leazer/MPS_MotorDriver/doc/msh_usart_dma_design_2026-06-24.md

# MSH 串口（USART1）DMA 化改造方案

日期：2026-06-24
作者：AI 协同（GLM-5.2 + 用户）
状态：✅ **已通过台架验证**（2026-06-24，用户确认整行粘贴不丢字符）

---

## 1. 背景

工程 MSH/finsh 控制台挂在 USART1（PB6 TX / PB7 RX，115200 8N1）。改造前的实现位于 `project/src/board.c:88-123`：

- `rt_hw_console_output`：**逐字节阻塞轮询** `USART_TDBE_FLAG` + `USART_TDC_FLAG`，每个字节都死等到完全发完才发下一个
- `rt_hw_console_getchar`：**直接读 `USART1->dt`**，硬件只有 1 字节 RDR，**无中断、无 FIFO、无环形缓冲**

### 1.1 现象

CLAUDE.md:133（Stage 2 调试结论）已记录：

> **finsh getchar 轮询限制**: `rt_hw_console_getchar()` (board.c) 是轮询读 USART, 无 RX 中断/FIFO. **一次性发送整行会 overrun 丢字符**. 自动化测试必须逐字符发送+等待回显 (tests/com9_test.py). Stage 8+ 若需高频调试可改 RX 中断驱动.

### 1.2 根因

USART1 硬件只有 1 字节接收寄存器（RDR）。115200 bps 下一个字节占 87 µs。当 finsh 在处理上一个字符、或 ISR（FOC TMR1_OVF 16 kHz / CAN_RX / EXINT2）抢占时，下一字节在 RDR 已被 USART 接收后若未及时被 CPU 读走，再到达的字节会触发 **ROERR overrun**，将前一字节冲掉。

FOC ISR 实测耗时 ~10-15 µs（电流读取 + Park/iPark + SVPWM + 标定 tick），加 SPI2 编码器读取 ~6 µs，单次 ISR 占 ~20 µs；115200 一字节 87 µs 余量本应足够，但 finsh 主循环 `finsh_thread_entry` (`shell.c:485`) 每读一个字符要做 echo + 行编辑 + 控制键状态机，处理一个字符耗时可超过 87 µs，外加 RT-Thread 调度延迟，**整行粘贴必然丢字符**。

## 2. 目标

| 维度 | 目标 |
|---|---|
| RX | 改 DMA 循环模式 + 软件环形 buffer（128 B），CPU 不再参与字符接收 |
| TX | 改 DMA 单次模式，一次推完整段字符串，仅在 DMA 完成时检查标志 |
| 接口 | `rt_hw_console_output` / `rt_hw_console_getchar` 签名不变，对 finsh / rt_kprintf 透明 |
| 系统耦合 | **不启用** `RT_USING_DEVICE`、不引入 serial 框架、不改 RT-Thread 源码、不新增中断 |
| RAM 预算 | ≤ 1 KB（RX ring 128 B + TX stage 256 B + 控制变量 ~16 B） |

## 3. 平台事实（改造前调研）

| 项目 | 值 |
|---|---|
| MCU | Artery AT32M412KBU7-4（**非 STM32**，AT32 标准外设库） |
| RT-Thread | Nano 4.1.x |
| 串口框架 | **无**（`RT_USING_DEVICE` 注释，纯 `rt_hw_console_*` weak hook） |
| 当前 DMA 使用者 | **0**（AT32 DMA 库 `at32m412_416_dma.c` 已编进固件但无人调用） |
| DMA 控制器 | DMA1（7 个通道 CH1-CH7） + DMAMUX（任意通道映射任意外设） |
| 参考实现 | 同根目录官方 `AT32M412_LV_MC_Library_Porject_V2.1.5/mclib/src/mc_comm_uart.c` 有完整 USART DMA TX/RX 示例 |

### 3.1 关键 AT32 库 API

```c
/* libraries/drivers/inc/at32m412_416_usart.h */
void usart_dma_transmitter_enable(usart_type* usart_x, confirm_state new_state);
void usart_dma_receiver_enable   (usart_type* usart_x, confirm_state new_state);

/* libraries/drivers/inc/at32m412_416_dma.h */
DMAMUX_DMAREQ_ID_USART1_TX = 0x19
DMAMUX_DMAREQ_ID_USART1_RX = 0x18
void dma_init(dma_channel_type *ch, dma_init_type *cfg);
void dma_flexible_config(dma_type *dma, dmamux_channel_type *mux_ch, dmamux_requst_id_sel_type req);
void dmamux_enable(dma_type *dma, confirm_state state);
void dma_channel_enable(dma_channel_type *ch, confirm_state state);
void dma_data_number_set(dma_channel_type *ch, uint32_t n);
uint16_t dma_data_number_get(dma_channel_type *ch);
flag_status dma_flag_get(uint32_t flag);
void dma_flag_clear(uint32_t flag);
```

## 4. 设计

### 4.1 DMA 通道分配（避免未来冲突）

| 通道 | 用途 | DMAMUX 请求 ID | 备注 |
|---|---|---|---|
| DMA1_CHANNEL1 | （预留 ADC） | — | 沿 STM32 习惯保留 |
| **DMA1_CHANNEL2** | **USART1_TX** | `DMAMUX_DMAREQ_ID_USART1_TX` (0x19) | 本次新增 |
| **DMA1_CHANNEL3** | **USART1_RX** | `DMAMUX_DMAREQ_ID_USART1_RX` (0x18) | 本次新增 |
| CH4 ~ CH7 | 预留 SPI2 MA600A / CAN / 其他 | — | — |

通道分配与官方 `AT32M412_LV_MC_Library_Porject_V2.1.5/user/inc/mc_hwio_m412_lv_v1_0.h:329-336` 一致，便于以后参考。

### 4.2 RX 工作原理（DMA 循环 → 软件环形 buffer）

```
                              ┌───────────────────────────┐
USART1 RDR                    │ s_rx_ring[128] (静态)     │
    │     RX_DMA 请求          │  ┌────────────────────┐  │
    └────────────────────────► │  │ 0  1  2 .. 127     │  │
                              │  └─▲──────────────────┘  │
                              │    │ DMA 写指针          │
                              │  (硬件: 128-CNDTR)        │
                              │                          │
                              │  s_rx_read_idx (软件读)  │
                              └───────────────────────────┘
```

- DMA1_CH3 配置 `loop_mode_enable = TRUE`，`buffer_size = 128`，方向 P2M
- 硬件在 CNDTR 到 0 时立即 reload 到 128 并继续搬运（环形）
- 软件 `write_idx = 128 - dma_data_number_get(CH3)` 始终落在 `[0, 128)`
- `getchar` 比较 `write_idx` 与 `s_rx_read_idx`：相等→无数据返回 -1；不等→取 `s_rx_ring[s_rx_read_idx]` 并 `(s_rx_read_idx+1) % 128`

**容量分析**：128 字节 @ 115200 = **11.1 ms 容忍窗口**。即使 finsh 整段卡 10 ms 不读，所有字符都能保留；远超原本 87 µs 的 1 字节窗口（提升 128×）。

**Overrun 策略**：如果 finsh 卡顿超 11 ms 导致 DMA 写指针追上软件读指针（即一整圈），最老的字符会被无声覆盖。这是设计上接受的失效——比当前 1 字节窗口好 128 倍，且实际 finsh 处理一行 < 1 ms，几乎不可能触发。

### 4.3 TX 工作原理（DMA 单次 + 等 FDT + 等 TDC）

```
rt_kprintf("msh />")
  └─ rt_hw_console_output("msh />")
      └─ board_usart1_tx_dma_send_str("msh />")
          ├─ 做 \n → \r\n 翻译，填 s_tx_stage[]
          └─ board_usart1_tx_dma_send(s_tx_stage, out_len)
              ├─ dma_channel_enable(CH2, FALSE)
              ├─ DMA1_CHANNEL2->maddr = stage 地址
              ├─ dma_data_number_set(CH2, out_len)
              ├─ dma_flag_clear(DMA1_GL2_FLAG)        ← 一次清全局 flag
              ├─ dma_channel_enable(CH2, TRUE)
              ├─ while(!dma_flag_get(DMA1_FDT2_FLAG)) ← 等 DMA 完成
              ├─ while(!usart_flag_get(USART1,TDC))   ← 等最后一字节移出
              └─ dma_channel_enable(CH2, FALSE)
```

- DMA1_CH2 配置 `loop_mode_enable = FALSE`，每次发送前设 maddr + buffer_size
- 调用方等 DMA FDT 完成；再等 USART TDC 确保最后一字节移出移位寄存器，避免下次 send 重置 maddr 时截断
- TX 仍是阻塞调用（保持与原 hook 一致的同步语义），但 **DMA 在传输期间不占 CPU**，FOC ISR 抢占时 DMA 仍继续推数据，丢字符窗口完全消失

**性能**：原实现每字节 = 2 次轮询 + 1 次写寄存器，每字节最坏 ~87 µs CPU 占用；新实现 N 字节一次 setup（~10 个寄存器写）+ N×87 µs 等 FDT（CPU 空转可被 ISR 抢占）。CPU 占用降低 ~10×。

### 4.4 不引入 IDLE 中断 / serial 框架的理由

- finsh `finsh_thread_entry` (`shell.c:487`) 主循环本就是 polling 模型：`while(1){ ch = finsh_getchar(); if(ch<0) continue; ... }`
- IDLE 中断的价值是"finsh 真正阻塞等数据时释放 CPU"，但 Nano 版 `finsh_getchar` 在 `RT_USING_DEVICE` 未开时就是 polling 返回 -1 + continue（`shell.c:148-189` 的 `#else` 分支），加 IDLE 无收益
- 启用 `RT_USING_DEVICE` 会拉入 serial 设备框架（v1 ~3 KB FLASH + 200 B RAM），不划算

## 5. 文件改动清单

| 操作 | 路径 | 行数变化 |
|---|---|---|
| 新增 | `platform/at32m412/board_usart1_dma.h` | +43 |
| 新增 | `platform/at32m412/board_usart1_dma.c` | +150 |
| 修改 | `platform/at32m412/board_init_at32m412.c` | +6 / -0 |
| 修改 | `project/src/board.c` | +17 / -32 |
| 修改 | `cmake/at32_workbench/CMakeLists.txt` | +1 |
| 修改 | `project/MDK_V5/MPS_MotorDriver.uvprojx` | +1 |
| 修改 | `CLAUDE.md` | 记录改造节点 |

### 5.1 改动要点

**`board_usart1_dma.h`** 暴露 4 个接口：
```c
void board_usart1_dma_init(void);
void board_usart1_tx_dma_send(const uint8_t *data, uint16_t len);
void board_usart1_tx_dma_send_str(const char *str);   /* 含 \n→\r\n 翻译 */
int  board_usart1_rx_dma_getchar(void);                /* 无数据返回 -1 */
```

**`board_usart1_dma.c`** 静态数据：
```c
static volatile uint8_t  s_rx_ring[128];   /* DMA 循环写入 */
static volatile uint16_t s_rx_read_idx;    /* 软件读指针 */
static uint8_t           s_tx_stage[256];  /* TX 准备缓冲 (\n→\r\n 最坏翻倍) */
```

**`board_init_at32m412.c::board_usart1_init()`** 末尾追加：
```c
usart_enable(USART1, TRUE);
board_usart1_dma_init();   /* ← 新增 */
```

**`project/src/board.c`** 两个 hook 简化为：
```c
void rt_hw_console_output(const char *str)   { board_usart1_tx_dma_send_str(str); }
char rt_hw_console_getchar(void)             { return (char)board_usart1_rx_dma_getchar(); }
```

## 6. 不改动的部分

- `rtconfig.h` / `finsh_config.h` 完全不动
- RT-Thread Nano 源码不动
- finsh 不动
- NVIC 不动（本方案 0 中断；DMA 完成靠轮询标志，避开 FOC/CAN 高优先级 ISR 争用）
- 其他外设（PWM/ADC/SPI2/CAN）完全无关

## 7. 风险与缓解

| 风险 | 缓解 |
|---|---|
| DMAMUX 配置顺序错位 → 通道工作异常 | 严格对齐官方 `mc_comm_uart.c` 顺序：`dma_init` → `dmamux_enable` → `dma_flexible_config` → `dma_channel_enable` |
| 循环 DMA 的 CNDTR 边界（满量 vs 0） | DMA reload 瞬间 CNDTR 会从 0 跳回 128，`write_idx = 128 - CNDTR` 配合模运算读指针正确（与 mc_comm_uart.c:141 同算法） |
| TX `\n→\r\n` 翻译后溢出 stage | `RT_CONSOLEBUF_SIZE = 128`，stage = 256 恰好容纳最坏翻倍；越界截断不阻塞 |
| RX 卡 > 11 ms 导致环形覆盖 | 接受失效（仅丢老字符），实际 finsh 处理一行 < 1 ms |
| 改造期间 console 完全失效 | 改动局限 board 层，可一次构建一次烧录验证；保留 git diff 可快速回退 |

## 8. 资源占用预估

- **FLASH**: +~600 B（新 .c 约 150 行 + DMA 库已编进固件无增量）
- **RAM**: +~410 B（s_rx_ring 128 + s_tx_stage 256 + 控制变量 ~16 + 函数栈 ~10）
- 当前 RAM 9520/16384 (58.11%) → 预计 ~9930 B (60.6%)，留 6 KB 空闲

## 9. 验证计划（待台架）

1. **构建**：WSL `cmake --build build/Debug` 和 Keil rebuild 均需 0 Error
2. **启动横幅**：上电后串口能看到 `\ | /` RT-Thread banner + `msh />` 提示符，且 `\r\n` 正确（终端不出现阶梯）
3. **回显**：逐字符敲 `help` 回车，回显与原行为一致
4. **关键回归**：终端一次性粘贴一行命令 `mc_open 1000 60 ramp`（>20 字符）→ **不再丢字符**，原本必丢
5. **批量回归**：用 Python 脚本一次性 `ser.write(b"mc_state\r\nfault\r\nencoder\r\n")` 不丢字符；与改造前 `tests/com9_test.py` 必须逐字符发的限制对比
6. **高负载场景**：在 `mc_open` / `mc_cur` ISR 持续 16 kHz 运行下做步骤 4，验证 DMA 不被 ISR 抢占影响
7. **长字符串 TX**：`mc_cal_dump`（256 行）输出不卡顿、不截断
8. **RAM/FLASH 占用**：与预估对比

## 10. 后续优化（不在本次范围）

- 若以后 SPI2 / ADC 都接 DMA 后调试发现 DMA1 总线竞争，可考虑：
  - 提高 USART1_TX/RX 通道 `priority` 字段（当前 LOW）
  - 或把 USART RX 改成 IDLE 中断 + 短帧 DMA，减少 DMA 占用率
- 若启用 `RT_USING_DEVICE` 把 USART 注册为 serial v2 device，可：
  - finsh 真正阻塞睡眠等 RX 信号量（IDLE 中断释放信号量），CPU 利用率更低
  - 支持 `rt_console_set_device` 切到 SWO/CAN 等

---

## 附录 A：当前 vs 新实现对比

| 维度 | 改造前 | 改造后 |
|---|---|---|
| TX 实现 | 逐字节 `usart_data_transmit` + 死等 TDBE+TDC | 一段 DMA + 等 FDT+TDC |
| TX CPU 占用 | 100%（每字节死等 87 µs） | ~10%（仅 setup + 等 FDT，可被 ISR 抢占） |
| RX 实现 | 直读 `USART1->dt`（仅 1 字节硬件 FIFO） | DMA 循环写入 128 B 环形 buffer |
| RX 丢字符窗口 | 87 µs（1 字节） | 11.1 ms（128 字节） |
| 抗 ISR 抢占 | 差（FOC 抢占即丢） | 优（DMA 与 CPU 并行） |
| 中断使用 | 0 | 0（DMA 完成靠轮询） |
| RAM 增量 | 0 | ~410 B |
| FLASH 增量 | 0 | ~600 B |
| 接口兼容性 | — | 完全兼容（hook 签名不变） |

## 附录 B：参考代码引用

- AT32 USART DMA 示例：`AT32M412_LV_MC_Library_Porject_V2.1.5/mclib/src/mc_comm_uart.c:42-95`（TX/RX DMA 初始化）
- AT32 USART DMA 通道分配：`AT32M412_LV_MC_Library_Porject_V2.1.5/user/inc/mc_hwio_m412_lv_v1_0.h:329-336`
- finsh getchar 主循环：`middlewares/rt-thread/components/finsh/shell.c:148-189`
- 原 console hook：`project/src/board.c:88-123`（改造前版本）
