leazer/MPS_MotorDriver/docs/superpowers/specs/2026-07-27-serial-forum-posts-video-redesign.md

# V2 四篇连载、比赛提交帖与 PPT 主线视频改版设计

日期：2026-07-27

## 1. 改版目标

保留原长篇草稿
`doc/第四篇过程帖_V2硬件与三环CAN调试_论坛草稿.md` 作为资料归档，
不删除、不覆盖。正式论坛内容改为第四至第七篇四篇短连载，并同步改写
最终比赛作品提交帖和演示视频脚本。

四篇连载都采用“图片先讲清楚，文字负责串联”的形式：

- 每篇约 1500～2500 个中文字符；
- 每篇安排 5～8 个清晰的图片占位；
- 延续前三篇的第一人称工程记录口吻；
- 已验证、正在调试和待补结果严格分开；
- 不重复堆叠安全上电流程和完整测试报告。

建议文件名：

1. `doc/第四篇过程帖_V2同轴磁编改版与波形_论坛草稿.md`
2. `doc/第五篇过程帖_三环LKS_Scope波形调试_论坛草稿.md`
3. `doc/第六篇过程帖_CAN协议与单节点联调_论坛草稿.md`
4. `doc/第七篇过程帖_五连杆轮腿Demo设计_论坛草稿.md`

## 2. 第四篇：V2 同轴磁编改版与波形

### 2.1 内容重点

1. 承接 V1：旁轴磁编能工作，但磁铁、传感器、转轴之间的相对位置让装配和
   标定更敏感，因此 V2 改为同轴布局。
2. 展示 V2 PCB Layout：MA600A 与电机轴线关系、磁铁位置、机械固定方式，
   以及相关布线变化。
3. 展示 PCB 和电机模组实物，强调结构更直接、装配关系更明确。
4. 说明采集链路：TMR7 以 4 kHz 独立采样，16 kHz FOC 中断读取已发布快照，
   避免在控制中断内直接阻塞 SPI。
5. 以手拖电机的 raw/corrected 角度波形为主要证据，观察连续性、周期回绕和
   毛刺情况。
6. V1 只有一张未标定波形，因此只作为背景参考，不写成严格同工况 A/B 测试。
7. 结论重点放在 V2：同轴安装后原始角度已经具备较好的可用性，标定从
   “补偿安装偏差”更接近“小误差修整”，标定难度明显下降。

### 2.2 表述边界

- 可以引用两套 V2 板自动标定均覆盖 256 bins、已有内部指标 115 mdeg 和
  60 mdeg、采集期间 spike 为 0。
- 115/60 mdeg 是内部 correction table 质量指标，不宣称为外部基准下的
  绝对精度。
- “接近直接使用”需由 V2 手拖 raw 波形的连续性支撑，不扩写成无需校准即可
  达到某一绝对精度。
- 本篇不介绍按安全顺序检查电源、PWM、驱动使能等上电流程。

### 2.3 图片规划

```text
[P4-01] V1 旁轴磁编结构或旧版 PCB 局部
[P4-02] V2 同轴磁编 Layout 总览
[P4-03] MA600A、磁铁与电机轴线局部放大
[P4-04] V2 PCB 与电机模组实物
[P4-05] 4 kHz 采集 / 16 kHz 控制数据链路图
[P4-06] V1 唯一一张未标定拖动波形（背景参考）
[P4-07] V2 手拖 raw 角度主波形
[P4-08] V2 corrected 波形或标定结果摘要
```

## 3. 第五篇：三环逻辑与 LKS Scope 调试

### 3.1 内容重点

1. 用一张图说明三环级联：
   `位置环 → 速度目标 → 速度环 → Iq 目标 → 电流环 → SVPWM`，
   编码器反馈位置/速度，电流采样反馈 Id/Iq。
2. 简介目前正在搭建的 LKS Scope 在线调参方案：
   `g_motor_tuning` 集中保存 RAM 在线参数，
   `g_motor_loop_debug` 提供运行快照。
3. 原有 11 条 Chart 曲线保持不变，数值表扩展到约 137 项；用户在
   LKS Scope 内按电流、速度、位置三个阶段自行选曲线。
4. 以图为主，分别放电流环阶跃、速度跟随、位置跟随三类代表波形。
5. 每张图只用一小段文字说明“目标、反馈、误差、输出/饱和状态怎么看”，
   不把正文写成完整 PID 教程。

### 3.2 表述边界

- LKS Scope 方案仍在构建和实机整理中，正文先给出真实架构和截图占位。
- 在线参数只存在 RAM，复位恢复默认值，不写成已经实现参数掉电保存。
- 不提前宣称最终三环波形已全部达到理想指标。

### 3.3 图片规划

```text
[P5-01] 位置—速度—电流三级级联逻辑框图
[P5-02] LKS Scope 在线参数与运行快照结构
[P5-03] LKS Scope 数值表/变量分组界面
[P5-04] Iq 电流环正向阶跃响应
[P5-05] Iq 电流环正反向或不同幅值阶跃
[P5-06] 速度目标与实际速度跟随
[P5-07] 位置目标与实际位置跟随
```

## 4. 第六篇：CAN 协议与单节点联调

### 4.1 内容重点

1. 用协议框架图说明 X-Track 与两个 MotorDriver 节点之间的关系。
2. 简述 Classic CAN、11-bit、DLC=8、1 Mbps，以及四类 ID：
   广播 `0x080`、轨迹 `0x100+node`、反馈 `0x180+node`、
   健康 `0x280+node`。
3. 用一张时序图说明“节点预装轨迹点 + 广播 SYNC”，以及
   DISCOVER、ARM、RUNNING/HOLD、STOP/FAULT。
4. 选取 `can_protocol.h/.c` 和 `can_motion_service.c` 的短代码片段，
   展示协议定义、命令分发和 1 kHz 服务。
5. 用历史日志讲一个真实调试问题：总线无 ACK 时进入 bus-off，持续错误中断
   一度让 COM9 看似卡死；改为 10 ms 状态轮询后，串口仍可响应，节点进入
   FAULT，EN 关闭。
6. 展示 X-Track 单节点 60 s 实测：最大 `sync_age=19 ms`，位置参考无冻结，
   protocol error / RX overflow / bus-off / TX error 均无增长。

### 4.2 已有素材与待补素材

现有材料足以生成论坛配图，不需要重新复现全部调试：

- `doc/调试记录.md` 第 1547～1644 行附近包含协议、超时、bus-off 与测试摘要；
- `docs/motor-control/test-reports/2026-07-22-xtrack-position-response.md`
  包含 60 s 实机结论与 CAN 错误统计；
- `docs/motor-control/evidence/` 保存 4 组原始 JSONL 和 Kp=5/7.5/10 汇总；
- `tests/stage8_can_bench.py`、`tests/stage8_canalyst_node1.py`、
  `tests/capture_xtrack_position_response.py` 保存台架与采集脚本；
- 协议和状态机源码均已保存。

目前没有现成 PNG/JPG。正式制作时把代码、终端日志和测试摘要排成三张统一风格
的清晰图片。若用户方便，再补一张 X-Track 实机控制画面或 CAN 分析仪收发界面，
但它不是成文前置条件。

### 4.3 表述边界

- 只写单节点 CAN 实机时序和安全验证已经通过。
- 10°位置响应没有达到既定 9.5°/350 ms 门槛，不能用 CAN 时序通过替代动态
  响应通过。
- Node 2 永久关节配置、双节点 applied sequence 一致性和五连杆联动仍按
  当前真实进度描述。

### 4.4 图片规划

```text
[P6-01] X-Track—CAN—双 MotorDriver 协议框架
[P6-02] 四类 CAN ID 与 8 字节载荷摘要
[P6-03] 预装轨迹点 + 广播 SYNC 时序图
[P6-04] can_protocol.h/.c 核心代码截图
[P6-05] can_motion_service 状态机/超时代码截图
[P6-06] 无 ACK → bus-off → 安全 FAULT 调试日志
[P6-07] X-Track 单节点 60 s 测试结果摘要
[P6-08] 可选：CAN 分析仪或 X-Track 实机界面
```

## 5. 第七篇：五连杆轮腿 Demo 设计

### 5.1 叙事开场

电机驱动模块完成后，需要一个既直观、又能体现双电机同步价值的展示载体。
论坛里已有坛友做力反馈旋钮、交互机器人等作品，最后选择用两个电机构成一个
五连杆轮腿 Demo：它本身是当前轮足机器人中常见的腿部模块，也能自然覆盖双
节点位置控制、机构运动学、3D 打印和装配联调。

### 5.2 数学原理

定义两个固定主动关节为 \(A\)、\(B\)，主动臂末端为 \(C\)、\(D\)：

\[
C=A+l_1[\cos\theta_1,\sin\theta_1],\qquad
D=B+l_2[\cos\theta_2,\sin\theta_2]
\]

末端点 \(P\) 是以 \(C\)、\(D\) 为圆心、以 \(l_3\)、\(l_4\) 为半径的两个圆
的交点。令：

\[
r=|D-C|,\quad
a=\frac{l_3^2-l_4^2+r^2}{2r},\quad
h=\sqrt{l_3^2-a^2}
\]

取 \(e=(D-C)/r\)，法向量 \(n=(-e_y,e_x)\)，则：

\[
P=C+ae\pm hn
\]

正负号对应两种装配支路，软件中固定选择与实物一致的一支。正文只解释几何意义，
不代入未确认的连杆尺寸，也不展开成冗长推导。

### 5.3 机械与控制方案

1. 展示五连杆 CAD 总装、连杆、轴承/紧固件、电机安装和 3D 打印方案。
2. 简述装配时需要统一机械零位、方向和软限位。
3. 用改造后的 X-Track 作为 CAN 示教/控制器，产生两个关节目标。
4. X-Track 分别向 Node 1/2 预装轨迹点，再发广播 SYNC；两块 MotorDriver
   各自完成位置—速度—电流三级闭环。
5. 当前双电机硬件已经搭建完成，X-Track 实际控制和最终动作仍在 debug。

### 5.4 图片规划

```text
[P7-01] 论坛常见展示形式与五连杆选择思路
[P7-02] 五连杆机构自由度与关节命名图
[P7-03] 两圆求交的正运动学示意图
[P7-04] 五连杆 CAD 总装截图
[P7-05] 关键零件/尺寸或工程图截图
[P7-06] 3D 打印件与装配过程
[P7-07] X-Track—CAN—双电机—五连杆结构框图
[P7-08] 已完成的双电机硬件实物，最终动作待补
```

## 6. 最终比赛作品提交帖

作品帖作为完整总览，不复制四篇过程帖的全部细节，主要结构为：

1. 作品简介与完成效果；
2. 电机模组总体设计框图；
3. MP4583、MP6540H、MA600A 与 AT32M412 的硬件分工；
4. 核心代码模块：
   `encoder_service`、`current_reconstruction`、`foc_core`、
   `current/speed/position_loop`、`motor_tuning`、`can_protocol`、
   `can_motion_service`、`joint_config`、`fault_manager`；
5. 五连杆 Demo 的选择理由和结构设计原理；
6. CAD/机械图、打印、装配和成品展示；
7. 调试结果的紧凑汇总与四篇过程帖链接；
8. 最终动作图片/GIF、视频链接、源码链接和总结。

最终效果未完成前继续保留唯一编号占位，不把“硬件已搭建”写成“完整动作已通过”。

## 7. 3 分 10 秒～3 分 30 秒 PPT 主线视频

### 7.1 表现形式

- 16:9、1080p/30 fps；
- AI 自动生成视觉风格统一的演示型 PPT 作为主线；
- 开头插入约 10～12 秒露脸自我介绍；
- 中间插入编码器、三环、CAN 的少量实测截图；
- 结尾以 MPS 双电机五连杆实际动作作为高潮；
- 旁白使用第一人称口语，不照念论坛正文。

### 7.2 建议时间轴

| 时间 | PPT/实拍内容 |
| --- | --- |
| 0:00–0:12 | 露脸：一句自我介绍 + 作品是什么 |
| 0:12–0:30 | 项目缘起：想做一块真正能带电机的紧凑驱动模块 |
| 0:30–0:52 | 模组总体框图与 MPS 器件 |
| 0:52–1:12 | V1 到 V2，同轴磁编改版 |
| 1:12–1:32 | 手拖波形与更容易标定的结果 |
| 1:32–2:00 | 三环逻辑 + 三张 LKS Scope 代表波形 |
| 2:00–2:20 | CAN 协议、SYNC 与一张联调日志 |
| 2:20–2:45 | 为什么选择五连杆、运动学与机械设计 |
| 2:45–3:18 | CAD/打印/装配快速过渡 + 最终动作实拍 |
| 3:18–3:28 | 随性收尾与项目链接 |

### 7.3 低成本制作方式

1. 先从本设计生成 10 页左右的 PPT 文案和统一视觉提示词；
2. 用 AI 演示工具生成基础页面，只手动替换 Layout、波形、CAD 和实物图；
3. PPT 导出视频或逐页录屏，转场只保留淡化、平移和局部放大；
4. 开场露脸一次拍完，技术画面使用后期旁白；
5. 五连杆最终动作固定机位连续拍 30～60 秒，再从中选 20～30 秒；
6. 没有最终动作时先完成除最后一页外的全部剪辑，联调完成后只替换末段。

## 8. 验收标准

1. 原 V2 长篇草稿原样保留；
2. 新建第四至第七篇四个独立 Markdown 草稿；
3. 第四篇不包含安全上电检查流程，不做伪严格 V1/V2 横评；
4. 第五篇以三环框图和 LKS Scope 波形为主；
5. 第六篇使用真实协议、代码、历史日志和单节点 60 s 证据；
6. 第七篇包含简洁可靠的五连杆几何原理和 X-Track 控制框图；
7. 最终作品帖改为完整模组与五连杆总览；
8. 视频脚本为 3:10～3:30 的 PPT 主线，旁白口语随性；
9. 双节点和最终动作没有完成前均保留明确占位。
