leazer/MPS_MotorDriver/docs/superpowers/specs/2026-07-29-final-submission-mps-writing-review-design.md

# 最终比赛作品提交帖：MPS 实体书写结果改版设计

日期：2026-07-29

## 1. 目标

根据用户已经修改的作品简介和最新实机结果，生成一份独立审阅稿：

`doc/最终比赛作品提交帖_根据新版简介调整_审阅稿.md`

原文件
`doc/最终比赛作品提交帖_论坛草稿.md`
保持不变，供用户对照。

## 2. 已确认事实

- 两套 V2 电机驱动与五连杆机构已经完成搭建和双节点联调。
- X-Track 使用预先生成的 MPS 末端轨迹，不是手动示教轨迹。
- 五连杆末端夹笔，已经在纸面留下实际的连续 MPS 笔迹。
- 整段轨迹能够流畅跑完。
- 当前字形效果一般，重复稳定性一般，仍有优化空间。
- 示教功能没有实现，审阅稿中删除或弱化相关描述。
- 没有可引用的轨迹误差、重复成功率、书写时长等量化结果，不得虚构。

## 3. 改写策略

采用“结果驱动、保留工程过程”的方案：

1. 保留原稿 13 节总体框架和前半篇已验证的硬件、三环、CAN 内容。
2. 从五连杆设计开始，将叙事从“计划用来验证”改为“已经落地到实体书写”。
3. 增加完整运行链路：

```text
预生成 MPS 末端坐标
  -> 轨迹缩放与离散
  -> 五连杆逆运动学
  -> Node 1 / Node 2 关节角
  -> CAN 轨迹预装 + 广播 SYNC
  -> 两个节点本地位置/速度/电流闭环
  -> 五连杆末端夹笔书写
```

4. 正面展示已经完成 MPS 实体书写，同时明确字形与重复稳定性一般。
5. 不用“完美复现”“高精度书写”“稳定重复”等缺少证据的宣传措辞。

## 4. 分节调整

### 第 1～5 节

- 保留用户修改后的简介、作者名和 AI 项目动机。
- 只做必要的中文标点、语序和论坛阅读节奏调整。
- 系统框图中的“旋钮 / 示教轨迹”改为“预设 MPS 轨迹 / 预设动作”。
- 保留 MP4583、MP6540H、MA600A、V2 同轴、三环与核心代码模块内容。

### 第 6 节：五连杆 Demo 设计

- 保留选择五连杆的理由和两圆求交正运动学。
- 补充实际控制使用逆运动学：从末端 MPS 坐标反求两个主动关节角。
- 将五连杆定位为双节点同步和末端实体书写的最终展示机构。

### 第 7～8 节：打印与装配

- 保留 CAD、打印、修孔、间隙和机械零位内容。
- 删除“Node 2 仍待配置”等过期状态。
- 改为两套节点已按机构零位、方向和软限位完成整机配置。

### 第 9 节：联调过程与当前结果

- 保留从单板、三环、单节点到双节点机构的递进路径。
- 增加预生成 MPS 轨迹到双关节 CAN 目标的完整数据流。
- 结果表更新为：
  - Node 2 已进入整机配置；
  - 双节点能够协同完成整段 MPS 书写；
  - 运动整体流畅；
  - 字形质量和重复稳定性一般。
- 单节点 10°/350 ms 历史门槛仍作为早期空载调试边界，不用它否定最终低速书写结果。

### 第 10 节：最终效果展示

- 删除“联调完成后再补”的过期文字。
- 直接写明末端夹笔在纸面留下连续 MPS 实体笔迹。
- 图片规划：

```text
[FINAL-05] 五连杆夹笔运行过程或连续动作截图
[FINAL-06] 纸面最终 MPS 笔迹近照
[FINAL-07] 最终参赛视频链接
```

- 结果表述为：

```text
完成度：整段 MPS 轨迹能够连续跑完
运动观感：整体流畅
当前不足：字形效果一般，重复稳定性一般
```

### 第 11 节：源码与使用说明

- 保留现有固件模块和构建说明。
- 增加轨迹生成、轨迹离散、五连杆逆运动学和 X-Track CAN 下发的职责说明。
- 如果源码中具体文件名尚未确认，只写功能模块，不虚构路径。

### 第 12 节：AI 协作

- 保留“以本项目测试 AI 在硬件开发中的作用”的主线。
- 将“剩下的能交给 AI 就让它去搞”整理成更自然的论坛表达。
- 强调 AI 参与资料梳理、代码、测试、排障记录和内容整理，最终结果仍由实物验证。

### 第 13 节：总结

- 从“仍在等待双节点联动”改为已经完成：

```text
V1/V2 驱动设计
  -> 同轴磁编
  -> 三环闭环
  -> 双节点 CAN
  -> 五连杆机构
  -> 纸面 MPS 实体书写
```

- 诚实保留字形、机械间隙、笔尖摩擦、零位一致性和重复稳定性等优化方向。

## 5. 文风

- 第一人称、工程论坛口吻，保留“两个吃灰电机”“这碟醋”“饺子包大了”等作者表达。
- 结果说清楚，但不改成产品宣传稿。
- 将“整体跑通”和“效果仍一般”同时写出来，避免只报喜或刻意贬低。
- 图片占位写明拍什么、证明什么，方便用户后续替换。

## 6. 验收标准

1. 新建独立审阅稿，不修改用户当前原稿。
2. 全文不再出现 Node 2 待配置、双节点联调中、最终轨迹待验证等过期状态。
3. 明确写出预生成轨迹，不出现已实现示教功能的结论。
4. 明确写出纸面实际 MPS 笔迹、整段流畅跑完。
5. 同时写出字形质量和重复稳定性一般。
6. 不虚构量化误差、运行时长、重复次数和成功率。
7. 后半篇与用户新版作品简介的完成状态一致。
