leazer/MPS_MotorDriver/doc/调试记录.md

# 调试记录

本文件记录样板调试、异常定位、参数调整和实测结果。所有测试记录尽量包含输入条件、连接方式、测试仪器、原始现象、判断过程和结论。

## 调试安全原则

1. 首次上电使用限流电源，电流限值从较低值开始。
2. 电机接入前先验证电源、MCU、传感器和驱动禁用状态。
3. MP6540H 使能前确认 PWM 默认状态、故障引脚状态和电源电流。
4. MA600A 安装和读取异常时，不急于闭环驱动电机。
5. 任何冒烟、异味、异常温升、异常电流，立即断电并记录现象。

## 调试记录模板

```text
日期：
记录编号：
调试目标：
硬件版本：
固件版本/提交号：
供电条件：
电机/负载：
测试设备：
连接方式：
操作步骤：
观测结果：
异常现象：
初步判断：
AI 辅助分析：
人工验证：
处理措施：
结论：
照片/波形/日志文件：
下一步：
```

## 2026-06-03 计划调试项

| 编号 | 调试项 | 状态 | 关键记录 |
| --- | --- | --- | --- |
| D001 | 样板外观和焊接方向检查 | 未开始 | 正反面照片、芯片方向、焊点、连接器 |
| D002 | 电源输入对地阻抗检查 | 未开始 | VIN-GND、低压电源轨-GND 阻值 |
| D003 | 限流电源首次空载上电 | 未开始 | 输入电压、电流限值、静态电流、温升 |
| D004 | MP4583 输出电压检查 | 未开始 | 输出电压、纹波、负载条件 |
| D005 | MCU 下载和串口日志 | 未开始 | 下载结果、启动日志 |
| D006 | MA600A 通信读取 | 未开始 | 原始角度值、旋转连续性 |
| D007 | MP6540H 禁用状态检查 | 未开始 | 使能脚、PWM 默认状态、故障脚、电源电流 |

---

## 2026-06-22 调试串口 finsh 接通 (3 轮调试)

### 背景
Stage 1 硬件 Bring-up 完成后, 接入 RT-Thread finsh/msh 调试控制台, 以便后续 Stage 通过 msh 命令自主闭环验证. 串口硬件: USART1 PB6(TX)/PB7(RX) 115200 8N1, 经 USB-TTL 连接 PC. 用户使用可控电源, 整体安全性可放心调试.

### 第 1 轮: 串口完全无输出

**现象**: 烧录后串口工具收不到任何数据 (完全静默).

**排查过程**:
1. 检查 finsh 配置: `RT_USING_FINSH` (finsh_config.h) 和 `RT_USING_CONSOLE` (rtconfig.h) 两个宏都被注释 → finsh 组件和 console 后端不编译.
2. 检查 USART1 硬件: `wk_usart1_init` 已在 Stage 0 Task 7 清空, platform 层 `board_init_at32m412.c` 未补 USART1 初始化 → 串口硬件未配置.
3. 检查引脚复用: `board_motor_pins.h` 里 USART1 的 `IOMUX` 写成 `GPIO_MUX_0`, 但 BSP 生成器 (git 6bbe9bd) 实际用 `GPIO_MUX_7` → 引脚复用选错 AF, 即使配置了也不工作.
4. 检查 finsh 源码: `shell.c / msh.c / msh_parse.c / cmd.c` 未纳入 CMake `RT-Thread_Nano_Src` 和 Keil .uvprojx 编译列表 → 宏开了也链接失败 (undefined reference to finsh_system_init).

**修复**:
- `finsh_config.h`: 开启 `RT_USING_FINSH`
- `rtconfig.h`: 开启 `RT_USING_CONSOLE`
- `board_motor_pins.h`: USART1 IOMUX `MUX_0` → `MUX_7`
- `board_init_at32m412.c`: 新增 `board_usart1_init()` (PB6/PB7 MUX_7 + 115200 8N1)
- `board.c`: `uart_init()` 改调 `board_usart1_init()`
- CMake + Keil: 纳入 finsh 4 个 .c 源文件
- 新建 `motor_shell.c`: 8 个 msh 命令 (pwm_info/pwm_duty/pwm_en/led/mc_state/fault/fault_clear/encoder)

**结果**: 编译链接通过, 但烧录后仍无输出.

### 第 2 轮: 串口初始化时序错误

**现象**: 第 1 轮修复后烧录, 串口仍完全静默.

**排查过程**:
梳理 RT-Thread 启动链路, 发现初始化顺序问题:
```
rt_hw_board_init()
  ├─ wk_system_clock_config()          ← 时钟 OK (180MHz)
  ├─ wk_periph_clock_config()          ← 已清空! 空操作!
  ├─ wk_nvic_config()                  ← 已清空! 空操作!
  ├─ rt_components_board_init()
  │    └─ uart_init() → board_usart1_init()  ← 此时 GPIOB/USART1 时钟未开!
  └─ SysTick_Config()

main()
  └─ motor_app_init()
       └─ board_clock_init()           ← 这里才开 GPIOB/USART1 时钟, 太晚了!
```

**根因**: `board_usart1_init()` 在 `rt_components_board_init` 阶段执行时, `CRM_USART1_PERIPH_CLOCK` 和 `CRM_GPIOB_PERIPH_CLOCK` 都没开 (它们在 `board_clock_init` 里才开, 而那要等到 main 线程的 `motor_app_init`). 往没开时钟的 USART1 寄存器写配置等于没写.

用户也指出 main.c 重复调用了 `clock_at32m412_init()` (与 `rt_hw_board_init` 里的 `wk_system_clock_config` 重复).

**修复**:
- `board.c` `rt_hw_board_init`: 把 `wk_periph_clock_config()`/`wk_nvic_config()` 替换为 `board_clock_init()`/`board_gpio_init()`/`board_nvic_init()` (在 `rt_components_board_init` 之前执行)
- `main.c`: 去掉重复的 `clock_at32m412_init()`
- `motor_app.c`: 去掉重复的 `board_clock_init/board_gpio_init/board_nvic_init` (已在 rt_hw_board_init 执行)

**结果**: 烧录后串口能打印 RT-Thread 版本横幅, 但没有 `msh />` 提示符, 无法输入.

### 第 3 轮: finsh 线程得不到调度

**现象**: 串口能打印版本横幅, 但没有 `msh />` 提示符, 无法输入命令.

**排查过程**:
版本横幅由 `rt_show_version()` 在 `rt_system_scheduler_start()` 之前打印 (不需要调度器). `msh />` 由 finsh 线程打印, 需要调度器启动后 finsh 线程被调度.

检查线程优先级:
- main 线程: 优先级 10 (RT_MAIN_THREAD_PRIORITY)
- finsh 线程: 优先级 21 (FINSH_THREAD_PRIORITY)
- 数值越大优先级越低

检查 `motor_app_run()`:
```c
void motor_app_run(void)
{
    while (1) {
        /* 空循环! 没有任何 rt_thread_mdelay / rt_thread_yield */
    }
}
```

**根因**: main 线程在 `motor_app_run` 的空 while(1) 里死循环, 不让出 CPU. 由于 main 线程优先级 (10) 高于 finsh 线程 (21), finsh 线程永远得不到调度, `msh />` 永远不出现.

**修复**: `motor_app_run()` while 循环加 `rt_thread_mdelay(10)`, 让 main 线程每 10ms 主动挂起, 给 finsh 线程调度机会.

**结果**: 烧录后出现 `msh />` 提示符, 所有 msh 命令可正常输入执行. `pwm_info` / `pwm_duty` / `pwm_en` / `mc_state` / `fault` / `led` 全部工作正常.

### 额外: LED 极性

**现象**: `led 1` 灭, `led 0` 亮, 与预期相反.

**根因**: 硬件 LED 负极接 IO, 低电平点亮. 程序里 `led 1` 执行 `gpio_bits_set` (高电平), 实际是灭.

**修复**: `motor_shell.c` led 命令反相 — `led 1` 执行 `gpio_bits_reset` (低电平=亮), `led 0` 执行 `gpio_bits_set` (高电平=灭). `board_gpio_init` 初始电平改为 set (灭). `board_motor_pins.h` 标注 LED 极性.

### 台架验证结果 (2026-06-22)

| 验证项 | 命令 | 结果 |
| --- | --- | --- |
| 串口版本横幅 | (上电自动) | ✅ 115200 8N1 正常打印 |
| msh 提示符 | (上电自动) | ✅ `msh />` 出现 |
| LED 控制 | `led 1` / `led 0` | ✅ 1=亮 0=灭 (修复极性后) |
| PWM 配置查看 | `pwm_info` | ✅ ARR=5624, 16kHz, CCR=2812(50%) |
| PWM 波形 | (示波器) | ✅ PA8/PA9/PA10 = 16kHz 中心对齐 50% |
| 状态机 | `mc_state` | ✅ state=0 mode=0 fault=0x40 (CAL_INVALID, 预期) |
| 故障查看 | `fault` | ✅ CAL_INVALID (标定未加载, 预期) |

### 踩坑总结 (后续避免)

1. **RT-Thread 初始化时序**: 板级硬件初始化 (时钟/GPIO) 必须在 `rt_components_board_init` 之前完成, 否则 INIT_BOARD_EXPORT 注册的设备初始化 (如 uart_init) 执行时硬件未就绪.
2. **main 线程 while 循环必须让出 CPU**: 否则所有低优先级线程 (finsh tshell 等) 饿死. 用 `rt_thread_mdelay` / `rt_thread_yield` / 等信号量.
3. **GPIO 复用编号查 BSP 生成器**: 手填 IOMUX 容易错, 以 Workbench 生成的 wk_*_init 里的 `gpio_pin_mux_config` 参数为准.
4. **ARMCC V5.06 默认 C90**: 不允许语句后声明变量 (GCC C11 允许). 跨编译器代码需用 C90 兼容写法 (变量声明在块开头).
5. **LED/继电器等外设极性**: 硬件接法决定 IO 电平语义 (低电平点亮 vs 高电平点亮), 代码需匹配, 头文件标注清楚.

---

## 2026-06-22 Stage 1 硬件 Bring-up (PWM 输出验证)

### 背景
Stage 0 基线重构完成后, Stage 1 实现最小集 TMR1 中心对齐 16kHz 3 路 PWM + 安全关断, 台架示波器验证波形.

### 关键决策: 系统时钟

spec §1.1 原标 96MHz, 但 `wk_system_clock_config` 实际配置 180MHz (PLL: 8MHz×90/(1×4)), 芯片 Flash 等待周期 5 支持 180MHz.

用户决定保持 180MHz (更强算力), 因此:
- `board_motor_pins.h`: `TMR1_CLOCK_HZ` = 180MHz, `TMR1_ARR` = 5624 (180e6/(2×16e3)-1)
- spec §1.1/§1.3/§1.4 时序常数同步更正为 180MHz

### 实现

- `board_init_at32m412.c`: 外设时钟 (GPIOA/B/TMR1/USART1/SCFG/PWC) + GPIO (nFAULT/LED/SPI2_CS/PWM_EN) + NVIC 优先级 (组4, TMR1_OVF=0/EXINT2=1/ADC=2/CAN=3/SysTick=14/PendSV=15, 仅设不使能)
- `motor_pwm_at32m412.c`: TMR1 中心对齐 TWO_WAY_3 + RCR=1 + ARR=5624 + 3路 PWM_MODE_A + CH4(ADC顶点触发预留) + brkdt禁用 + 50% 初始占空比
- `motor_app_init()`: 接入 board_init + motor_pwm_safe_init (MP6540H EN 保持低)

### 台架验证

示波器探 PA8/PA9/PA10, 确认 16kHz 中心对齐 50% 三相对齐波形. MP6540H_EN (PB10) 保持低 (禁用状态, 安全).

**结果**: ✅ PWM 波形正确, Stage 1 验收通过. (后通过 msh `pwm_info` 命令二次确认配置参数)

### RT-Thread 临界区发现

调研发现本工程 RT-Thread libcpu 的 `rt_hw_interrupt_disable` 用 PRIMASK (全局关中断), 非 BASEPRI. spec §3.5 原写的 `RT_KERNEL_BASEPRI` 不适用. Stage 1 不使能 TMR1_OVF 中断故无影响, FOC ISR 屏蔽风险留到 Stage 2/3 实测.

---

## 2026-06-22 Stage 0 基线重构

### 背景
工程原始为 AT32 Workbench 生成的扁平结构, 代码堆在 project/src/. 需重构为分层架构 (application/platform/communication) 以支持后续 FOC 开发.

### 完成
- 12 个 Task: 目录骨架 + 引脚/参数头文件 + 各层 stub + wk_*_init 清空 + main.c 精简 + CMake 纳入 + FLASH.ld 预留标定区 + 单元测试 + 文档
- 资源占用: FLASH 14712B / RAM 3552B (纯骨架, 无业务逻辑)
- 已有资产保留: motor_control 状态机, motor_pwm 安全接口, MA600A 驱动, 1 个状态机测试

### Keil 工程同步
Stage 0 完成后, Keil .uvprojx 与 CMake 源文件列表不同步 (Keil 只有 6 个旧源). 补全 17 个新源 + 4 个 include 路径 + IROM 127K. 写 build.bat / flash.bat / clean.bat 脚本调用 UV4.exe.

---

## 调试环境

- **硬件**: AT32M412KBU7-4 + MP6540H (三相半桥驱动) + MA600A (磁编码器) + JLink 调试器 + USB-TTL 串口 (PB6/PB7)
- **可控电源**: 用户使用可控电源, 整体安全性可放心调试
- **编译器**: Keil ARMCC V5.06 (-O1, C90) / WSL arm-none-eabi-gcc (-O0, C11)
- **构建**: `cd project\MDK_V5 && build.bat` (Keil) 或 `wsl cmake --build build/Debug` (GCC)
- **烧录**: `cd project\MDK_V5 && flash.bat` (JLink)
- **串口**: 115200 8N1, PB6(TX)/PB7(RX), finsh msh 提示符 `msh />`
- **示波器**: PA8/PA9/PA10 (PWM), PB10 (MP6540H EN)

---

## Stage 2: PWM 与开环控制 - 2026-06-22

### 记录编号
S2-001

### 阶段
Stage 2 (PWM 与开环控制)

### 目标
实现 FOC 核心变换 (Clarke/Park/IPark/SVPWM) + ISR 骨架 OPEN_LOOP 模式, 通过 msh 命令触发开环旋转, 验收三相电流正弦.

### 硬件版本
AT32M412KBU7-4 + MP6540H + MA600A

### 固件版本
Stage 2 完成 (WSL GCC + Keil ARMCC 双构建 0 error 0 warning)

### 供电条件
(待台架验收) 限流电源 12V, 限流 0.3A

### 电机/负载
2808 BLDC, 7 对极 (待实测确认)

### 仪器
JLink, USB-TTL 串口, 示波器 (PA8/PA9/PA10 PWM + 电流探头)

### 操作步骤
1. `cd project\MDK_V5 && flash.bat rebuild` 烧录
2. 串口连 PB6(TX)/PB7(RX) 115200, 见 msh 提示符
3. `mc_state` 确认 state=DISABLED, fault=0
4. `mc_open 1.0 60` (1V d 轴, 60rpm 电角度)
5. 示波器看 PA8/PA9/PA10 三相 PWM + 电流探头看相电流
6. `mc_debug` 观察 theta_e 递增, v_alpha/v_beta 正弦, CCR 限幅内
7. `mc_stop` 停止

### 观察结果
(待台架验收填写)

### 异常现象
(待台架验收填写)

### 初步判断
(待台架验收填写)

### 处理措施
(待台架验收填写)

### 验证方法
- 示波器: 三相 PWM 16kHz 中心对齐, 互差 120°, 调制比 ~ m=vd/vbus
- 电流探头: 三相正弦, 平衡度 < 5%, 电流 < 限流值
- msh: mc_debug 的 theta_e 持续递增, tick_count 按 16kHz 累加

### 结论
(待台架验收填写)

### 照片/波形/日志路径
(待台架验收填写)

### 下一步
- 台架验收通过后进入 Stage 3: ADC 同步采样与电流反馈
- Stage 3 将接入 ADC2 注入序列 (TMR1_CH4 触发), 实现零偏标定 + 实时电流采样, 替换 ISR 内固定 12V VBUS

### 关键代码变更
- `application/motor_control/foc_core.c`: sin/cos LUT (256点) + Park/IPark + SVPWM (min-max 零序注入)
- `application/motor_control/motor_control_isr.[ch]`: OPEN_LOOP 模式 (角度斜坡 + IPark + SVPWM), open_loop_start/stop/get_debug API
- `platform/at32m412/motor_pwm_at32m412.[ch]`: TMR1_OVF_TMR10_IRQHandler + enable/disable_ovf_irq
- `application/motor_app.[ch]`: motor_app_get_control_rw() 可写访问器
- `application/motor_shell.c`: mc_open / mc_stop / mc_debug 命令

### 资源占用
- WSL GCC: FLASH 58920B (45.31%) / RAM 5976B (36.47%)
- Keil ARMCC -O1: Code 30764 + RO 3732, ZI 4948, 0 Error 0 Warning

---

## Stage 2 Bug 修复: CCR=0 + kprintf %f - 2026-06-22

### 记录编号
S2-002

### 阶段
Stage 2 (调试修复)

### 目标
修复 mc_open 启动后 mc_debug 显示 CCR=0/0/0 的 bug, 以及 shell 浮点打印异常.

### 问题描述
1. **shell 浮点打印异常**: mc_debug 输出 `theta_e : %f rad (%f deg)`, mc_open 输出 `vd=%fV`, 所有 `%.2f`/`%.3f` 原样打印为字面 "%f"
2. **CCR=0**: mc_open 1000 60 启动后 (active=1, tick_count 递增), 但 CCR1/2/3 = 0/0/0, 电机不出力

### 根因分析
**问题 1**: RT-Thread Nano 的 `rt_kprintf` (kservice.c) 是最小化整数 printf, **不支持 %f**. 所有浮点格式串原样输出.
**问题 2**: ISR 诊断计数器定位到 `fault_hits` 持续递增而 `ol_hits=0`. 根因是 `motor_calibration_load()` 开机置位 `FAULT_CAL_INVALID` (0x40), 而 ISR 用 `fault_manager_any()` 检查"任意故障" → 把告警级 CAL_INVALID 当致命故障 → 走 fault 分支强制 50% 同电位 → CCR 看似为 0 (实际是 50% 但 s_dbg_ta 未写入).
- spec §4.7.3 明确: "FAULT_CAL_INVALID 不阻止电机使能, 但应作为告警"
- mc_open 检查的是 `motor_control.fault_flags` (实例自己的, =0), ISR 检查的是 `fault_manager` 的 `s_fault_flags` (=0x40), 两个故障系统不同步

### 处理措施
1. **%f 修复**: 所有 shell 浮点输出改为整数定点 (mV/mrad/mdeg/mrpm). mc_open 参数从 vd_volts (浮点V) 改为 vd_mv (整数毫伏). encoder 命令同步改.
2. **故障分级修复**:
   - `fault_manager.h` 新增 `FAULT_FATAL_MASK` = DRIVER|OVERCURRENT|SENSOR|UNDERVOLTAGE|OVERVOLTAGE (不含 CAL_INVALID/CAN_TIMEOUT)
   - 新增 `fault_manager_any_fatal()`: 仅致命位
   - ISR 故障分支改用 `fault_manager_any_fatal()` (非 `any()`)
   - mc_open 启动检查改用 `fault_manager_any_fatal()` (与 ISR 一致)
3. **ISR 诊断计数器**: mc_debug 新增 `ol_branch_hits`/`fault_hits`/`disabled_hits`, 用于定位 ISR 走哪个分支

### 验证方法
通过 COM9 (JLink CDC UART) 逐字符发送命令 (适配 finsh 轮询 getchar), 验证:
```
mc_open 1000 60
mc_debug  -> ol_hits=32647 递增, fault=0, CCR=3186/2643/2437
mc_debug  -> theta=518mrad, valpha=786mV, vbeta=495mV (正弦变化)
```
数学验证: √(918²+253²)≈952mV ≈ vd=1000mV ✓; CCR 均值≈2755 ≈ 2812(50%) ✓; m=1/12=0.083, CCR 波动±375 ≈ 2812×0.083 ✓

### 关键发现 (finsh 串口限制)
- `rt_hw_console_getchar()` (board.c) 是**轮询**读 USART, 无 RX 中断/FIFO. 一次性发送整行会 overrun 丢字符 (只回显首字符).
- 自动化测试必须**逐字符发送 + 等待回显**, 模拟人工输入. tests/com9_test.py 已实现此模式.
- Stage 8+ 若需高频 CAN 调试, 考虑把 getchar 改为 RX 中断驱动 (需评估 RAM/复杂度).

### 结论
Stage 2 开环控制逻辑 (角度斜坡 + IPark + SVPWM) 验证正确, CCR 输出符合 SVPWM 数学预期. 故障分级修复使 CAL_INVALID 告警不再阻止开环测试.

### 照片/波形/日志路径
tests/com9_test.py (自动化测试脚本), 本节日志

### 下一步
- 示波器台架验收: PA8/PA9/PA10 三相 PWM + 电流探头看正弦
- 进入 Stage 3: ADC 同步采样, 替换 ISR 内固定 12V VBUS 为实测

## Stage 3: ADC 同步采样与电流反馈 - 2026-06-22

### 记录编号
S3-001

### 调试目标
Stage 3 (ADC2 注入序列 + TMR1_CH4 触发 + 零偏标定 + VBUS 读取 + ISR 电流/电压反馈)

### 实现内容
1. `current_sense_at32m412.c`: ADC2 注入序列 3 通道 (SOA/SOB/SOC) + TMR1_CH4 触发 + VBUS 普通序列 + 零偏标定
2. `motor_pwm_at32m412.c`: CH4 配置为输出比较通道 (tmr_output_channel_config) + 触发点改为谷底
3. `motor_control_isr.c`: 每 tick 读 ADC 算电流, VBUS 1kHz 分频采样, 过流/不平衡保护, VBUS 替代硬编码 12V
4. `motor_shell.c`: 新增 mc_current / mc_cal / vbus 命令

### 关键 Bug 定位与修复

#### Bug 1: 板子无法启动 (ADC 校准挂死)
- **现象**: 烧录后串口无 msh 提示符, 板子不启动
- **根因**: `current_sense_at32m412_init()` 只开了 `CRM_ADC1_PERIPH_CLOCK`, 未开 `CRM_ADC2_PERIPH_CLOCK`. AT32M412 的 ADC1/ADC2 有独立时钟使能位, 但 ADC common 配置需 ADC1 时钟. 仅开 ADC1 时, ADC2 使能后校准 while 循环永久挂起 (adc_flag_get(ADC_RDY_FLAG) 永远 RESET)
- **修复**: 同时开 `CRM_ADC1_PERIPH_CLOCK` + `CRM_ADC2_PERIPH_CLOCK`. 另外给所有 ADC 校准 while 循环加超时保护 (100000 次循环), 防硬件异常时挂死

#### Bug 2: ADC 注入序列返回全 0
- **现象**: mc_current 显示 ia=0 ib=0 ic=0 (raw 全 0), 零偏标定失败 (offset=0)
- **根因**: TMR1 CH4 仅调用 `tmr_channel_value_set(TMR1, CH4, ARR)` 设比较值, 未调用 `tmr_output_channel_config(TMR1, CH4, ...)` 配置为输出比较通道. CH4 不产生比较事件, ADC 注入序列无法被 TMR1_CH4 触发, 注入数据寄存器保持 0
- **验证**: 对照参考工程 mc_hwio.c line 226/1313, 参考工程对 ADC_TIMER 的 CH4 调用了 `tmr_output_channel_config`
- **修复**: `motor_pwm_at32m412_init()` 中 CH4 增加 `tmr_output_channel_config` + `tmr_output_channel_buffer_enable`

#### Bug 3: ADC 采样点错误（2026-07-21 已更正）
- **当时现象**: CH4 配置正确后, ADC raw 全部接近 2048 (V_REF), 即使电机旋转电流也不变化。
- **当时误判**: 2026-06-22 曾错误地把 SOx 解释为另一桥臂导通有效，并把 CH4 从 ARR 改到谷底 1。该解释已被后续占空比扫描、全象限闭环和 MP6540H 低边电流检测语义否定，不应再作为采样设计依据。
- **更正结论**: SOA/SOB/SOC 对应各相低边器件电流。当前固定采样点为 `CCR4=5264`，软件按 `sample_tick-duty >= 180` 判断低边稳定窗口，选择两相并用 `Ia+Ib+Ic=0` 重构第三相；低边器件电流在进入 FOC 前统一转换为电机相电流符号。
- **最终验证**: 详见 2026-07-20/21 记录。±50/100/200/500mA 八点均为 `valid_mask=0x07`，Iq 最大偏差 4mA、|Id| 最大 5mA、invalid/freeze 不增长。

#### Bug 4: 零偏标定窗口过严
- **现象**: mc_cal 报 FAIL (a=2070 b=2068 c=2069, 偏差 22 LSB > 窗口 20 LSB)
- **根因**: 4.7k/4.7k 分压电阻 1% 容差 + MP6540H 电流镜偏置, 实际零偏 ~2068-2070, 偏差 20-22 LSB. spec §4.3.3 原文 20 LSB 窗口过严
- **修复**: 窗口放宽到 50 LSB (≈0.16A), 在安全范围内

#### Bug 5: 标定时 MP6540H 未使能
- **现象**: mc_cal 标定 a=1643 (偏差 405 LSB), b/c 接近 2048
- **根因**: MP6540H EN=LOW (禁用) 时电流镜电路未上电, SO 引脚偏置不正常. spec §4.3.3 要求 "low-side 都在导通", 意味着芯片需使能
- **修复**: mc_cal 标定前 `motor_pwm_at32m412_enable_output()` (EN=HIGH), 50% 占空比三相同电位无电流, 标定后 `disable_output()`

### 台架验证结果 (COM9 串口自动化测试)

| 验证项 | 命令 | 结果 |
| --- | --- | --- |
| VBUS 读取 (3 次一致性) | vbus ×3 | 11.90/11.87/11.93V, 一致性 < 0.1V ✓ |
| 零偏标定 | mc_cal | a=2068 b=2068 c=2064, 偏差 < 50 LSB, PASS ✓ |
| 静态电流 (50% 无负载) | mc_current | ia=63 ib=-37 ic=91 mA (≈0, 噪声) ✓ |
| 开环旋转 1V/60rpm | mc_open 1000 60 | 电流 -94~138 mA, 无故障 ✓ |
| 开环旋转 2V/120rpm | mc_open 2000 120 | 电流 -116~63 mA, 无故障 ✓ |
| VBUS 旋转中稳定 | mc_debug | 11.83-11.93V (无跌落) ✓ |
| 过流保护 | (未触发) | oc_hits=0 (电流远低于 5A 阈值) ✓ |
| 不平衡保护 | (未触发) | imbal_hits=0 (sum < 1500 mA) ✓ |
| 停止后电流归零 | mc_current | -50~-104 mA (噪声) ✓ |
| 最终故障状态 | fault | 0x00000000 (无故障) ✓ |

### 结论
Stage 3 ADC 电流采样与 VBUS 反馈验证通过. 三个关键 bug (ADC 时钟/CH4 配置/采样点) 通过系统排查定位修复. 电流读数在开环旋转时随电机状态变化, 静态接近零, VBUS 读数准确稳定. 过流/不平衡保护逻辑就绪但未触发 (空载电流小).

### 照片/波形/日志路径
tests/stage3_final.py (自动化测试), tests/stage3_final_results.txt (结果)

### 下一步
- 示波器台架验收: 电流探头看三相 SOA/SOB/SOC 波形, 验证正弦度
- 进入 Stage 4: MA600A 编码器接入, 实现电角度闭环准备

---

## Stage 5 调试: PA7 (SOC) ADC 读数异常 — 芯片引脚硬件损坏 - 2026-06-24

### 记录编号
S5-DBG-001

### 调试目标
排查 ADC2 注入序列中 SOC (PA7/ADC2_IN7) 读数恒为 ~0x000F (接近 0), 而 SOA (PB1/CH9)、SOB (PB0/CH8) 正常 (~2048) 的原因。

### 现象
- Keil 调试器寄存器界面: SOA/SOB 注入数据 ~2048 (正常零电流), SOC ~0x000F 波动 (异常)
- PA7 引脚外部实测电压 ~1.65V (MP6540H SOC 输出, 应读 ~2048)
- 硬件已排查: 焊接无问题, 端口电压 1.7V 正常
- SOA/SOB 同板同芯片正常 → 排除芯片整体故障

### 排查过程 (systematic-debugging)

#### Phase 1: 证据收集
1. **代码配置确认** (`current_sense_at32m412.c` / `board_motor_pins.h`):
   - SOA=PB1/ADC2_CH9, SOB=PB0/ADC2_CH8, SOC=PA7/ADC2_CH7
   - 三相 GPIO 均配 `GPIO_MODE_ANALOG` + `GPIO_PULL_NONE`, 无 mux (ANALOG 模式不需要)
   - board_gpio_init 只配 PA0(LED)/PA15(CS), 未碰 PA7
   - ADC2 注入序列顺序 SOA→SOB→SOC, TMR1_CH4 触发

2. **PA7 复用功能查证** (DS_AT32M412_416 V2.02, page 25):

   | 模式 | PA7 复用功能 |
   |---|---|
   | ANALOG | ADC2_IN7 / CMP2_INP0 / OP1_INP2 / OP2_INP0 |
   | 默认 | **OP2_OUT** (运放2输出) |
   | MUX_1 | TMR1_CH1C (互补) / TMR3_CH2 / TMR11_CH1 |
   | MUX_5 | SPI1_MOSI / I2S1_SD |
   | MUX_4 | I2C2_SCL / CMP2_OUT |

   **PA7 是 OPAMP2 的输出引脚**。PB0/PB1 的复用功能里**没有 OPAMP 输出**, 这解释了为何只有 SOC 异常。

3. **OPAMP 默认状态查证** (RM_AT32M412_416, §21 运算放大器):
   - `OPx_CTRL.OPEN` 复位值 = 0x0 (运放默认禁用)
   - `OPx_CTRL.OPOUTSEL` 复位值 = 0x0 = "OP 输出到 GPIO 上" (即使 OPAMP 禁用, 输出端仍连 GPIO)

#### Phase 2: 假设与验证

**假设 A (被证伪): OPAMP2 输出占用 PA7**
- 设 `OP2_CTRL.OPOUTSEL=1` (OP 输出重定向内部 ADC, 释放 GPIO)
- `OP2_BASE = 0x40013B04` (at32m412_416.h: APB2PERIPH_BASE + 0x3B04)
- 写入后读回: `OP2_CTRL before: 0x00000000`, `OP2_CTRL after: 0x00000100` (bit8=1 确认写入生效)
- **结果: PA7 仍 1.65V, ADC 仍异常** → 假设 A 推翻
- 注: OPAMP 禁用时 (OPEN=0) 输出级本就无驱动能力, OPOUTSEL 对禁用 OPAMP 影响有限, 故与本次故障无关

**假设 B (排除): TMR1_CH1C 互补通道驱动 PA7**
- 查 `motor_pwm_at32m412.c`: `occ_output_state = FALSE` (明确禁用互补), 只配 CH1/2/3/4
- TMR1 GPIO mux 只配 PWMA/B/C (PA8/9/10), 未碰 PA7
- → 排除

**假设 C (排除): CMP2 比较器影响**
- PA7 = CMP2_INP0 (输入, 高阻), CMP2_OUT 输出需 MUX_4 (本工程未设)
- → 排除

**假设 D (确认): 芯片 PA7 硬件损坏**
- 决定性验证: OPAMP 已断开 (OPOUTSEL=1 读回确认) + PA7 配推挽输出置 0
- 对照组 PA0 同样推挽置 0 → **PA0 = 0V** (测试方法有效)
- **PA7 仍 1.65V** (推挽输出无法驱动)
- 1.65V ≈ VREF/2 (3.3V/2), 是损坏引脚内部固定电平的典型特征

### 结论

**根因: AT32M412 芯片 PA7 引脚硬件损坏。**

在 OPAMP2 输出已断开 (OPOUTSEL=1 读回确认)、TMR1_CH1C 未配置、CMP2 未激活的情况下, PA7 配推挽输出置 0 仍稳在 1.65V (= VREF/2), 只剩芯片引脚硬件损坏一个解释。PB0/PB1 同板正常, 排除芯片整体故障, 为 PA7 单引脚问题。

**OPOUTSEL 与本次故障无关**: OPAMP2 默认禁用 (OPEN=0), 输出级无驱动能力, 不构成"冲突致伤"条件。设 OPOUTSEL=1 既不是根因也不是必要预防措施。

### 致伤原因
未明。可能因素: ESD、焊接热损伤、引脚瞬时过压、出厂缺陷。无证据指向具体原因。

### 处理措施
1. **换芯片验证**: 换一片 AT32M412, 烧同样固件, PA7 若恢复 ~2048 → 实锤该芯片 PA7 损坏。这是最终确认, 也是解决方案。
2. **临时绕过 (若急用)**: 无法绕过。MP6540H 三相电流采样缺一相即无法做完整 FOC, 软件估算 ic=-ia-ib 不含 C 相真实信息, 只适合无负载验证。

### 验证方法
- 软件验证 OPAMP 断开: `*(volatile uint32_t*)0x40013B04 = (1u<<8)`, 读回 0x100
- 推挽对照测试: PA0 推挽置 0 → 0V (正常), PA7 推挽置 0 → 1.65V (异常)
- 换片确认: 新芯片 PA7 ADC 读数 ~2048

### 换片后实测结果 (2026-06-26 追加)

换了芯片后, 烧录电机驱动固件**第一次上电 PA7 仍异常**。随后用 AT32M412 标准库 GPIO 例程测试 PA7 IO 反转, 万用表测得电平能正常翻转。之后再烧回电机驱动固件, **ADC 读数恢复正常**。

### 暂时结论 (待第二块板验证)

**换芯片后 PA7 恢复正常**, 但恢复过程出现两个未完全解释的现象:
1. 换片后第一次烧电机固件仍异常
2. 跑一遍 GPIO 例程 (IO 反转) 后, 再烧电机固件才正常

可能的解释 (未证实): 某种引脚/外设状态的"残留"——首次上电时 PA7 的模拟外设 (OPAMP/CMP) 或 GPIO 配置处于非预期状态, GPIO 例程对 PA7 做了完整的数字 IO 配置 (含 mux/clear), 相当于一次"复位清扫", 之后电机固件再配置 ANALOG+ADC 才生效。也可能旧片确实损坏、新片只是首次配置时序巧合。

**判定为芯片问题的依据尚不充分**。旧片推挽置 0 仍 1.65V 是硬证据指向损坏; 但新片"换片即好"被 GPIO 例程这个中间步骤搅动, 不能 100% 排除"配置残留"类根因。**待焊接第二块板时复测**: 若第二块板首次烧电机固件即正常 → 旧片损坏实锤; 若第二块板也复现"首次异常、跑 GPIO 例程后正常" → 根因倾向配置残留, 需排查 init 时序。

### 关键参考资料
- 数据手册: `DS_AT32M412_416_V2.02_CH.pdf` page 25 (PA7 复用功能表)
- 用户手册: `RM_AT32M412_416_CH_V2.01.pdf` §21 (OPAMP), page 400-401 (OPEN/OPOUTSEL 寄存器位)
- 寄存器地址: `at32m412_416.h` OP2_BASE = APB2PERIPH_BASE + 0x3B04

### 踩坑总结
1. **PA7 是 AT32M412 的特殊引脚**: 默认连 OPAMP2 输出 (OP2_OUT), ANALOG 模式下同时连 ADC2_IN7/CMP2/OPAMP 多个模拟外设。排查 ADC 异常时必须先查数据手册复用功能表, 不能假定普通 ADC 引脚。
2. **OPAMP 禁用 ≠ 输出端断开**: OPEN=0 (运放禁用) 时 OPOUTSEL 仍控制输出端是否连 GPIO。但禁用 OPAMP 输出级无驱动能力, 实测对本故障无影响。
3. **推挽对照测试是判芯片损坏的有效方法**: 同板选一个已知正常引脚 (如 PA0) 做同样配置对照, 排除软件配置问题, 单引脚异常即指向硬件。
4. **VREF/2 电平是损坏引脚特征**: 引脚内部通路断开/短路时, 常稳在半电源电平。
5. **"换片即好"需谨慎归因**: 若换片后恢复过程中跑了其他固件 (如 GPIO 例程), 不能简单归因芯片损坏。需用全新板/全新片首次只烧目标固件来排除配置残留。

### 下一步
- 焊接第二块板, 首次只烧电机驱动固件 (不跑 GPIO 例程), 观察 PA7 ADC 是否首次即正常
- 若第二块板首次正常 → 旧片损坏实锤, 本问题关闭
- 若第二块板首次也异常 → 排查 init 时序/外设残留 (board_clock_init 与 current_sense_gpio_init 的先后, OPAMP/CMP 寄存器是否需显式清零)
- PA7 正常后继续推进 Stage 5 电流环台架验收 (stage5_bench.py)

## finsh 方向键显示 [A [B [C [D — getchar 返回类型 bug - 2026-06-26

### 记录编号
S5-DBG-002

### 阶段
Stage 5 电流环台架验收调试期间

### 现象
串口终端 (putty/SSCOM) 按上下左右方向键, 屏幕显示 `[A [B [C [D` 字符, 不能切换历史命令, 不能移动光标。

### 根因
`rt_hw_console_getchar` (board.c) 声明返回 `char`, 内部调用 `board_usart1_rx_dma_getchar()` (返回 `int`, -1 = 无数据)。

```
board_usart1_rx_dma_getchar() 返回 int: -1 (0xFFFFFFFF)
    ↓ char 截断
rt_hw_console_getchar 返回 char: 0xFF
    ↓ 隐式提升回 int
finsh_getchar 返回 int: 0x000000FF = 255
    ↓ shell.c:488
if (ch < 0)  →  255 > 0, 检查失败, 不 continue
    ↓
255 被当有效字符塞进方向键 ESC 序列中间
```

方向键序列是 `ESC(0x1b) → [(0x5b) → A/B/C/D(0x41-44)` 三字节状态机 (shell.c:500-517):
1. 收到 `0x1b` → `shell->stat = WAIT_SPEC_KEY`
2. 收到 `0x5b` → `shell->stat = WAIT_FUNC_KEY`
3. 收到 `0x41-44` → 执行方向键动作

ESC 和 `[` 之间如果 DMA buffer 暂时无数据, `getchar` 返回 `-1`, 经 `char` 截断变 `255`, shell 把 255 当有效字符处理 → 状态机从 `WAIT_SPEC_KEY` 回到 `WAIT_NORMAL` (0xFF != 0x5b) → 后续的 `[` 和 `A/B/C/D` 被当普通字符回显。

### 修复
- `project/src/board.c`: `rt_hw_console_getchar` 返回类型 `char` → `int`, 直接 return `board_usart1_rx_dma_getchar()` (不再截断)
- `middlewares/rt-thread/components/finsh/shell.c`: `extern char rt_hw_console_getchar(void)` → `extern int rt_hw_console_getchar(void)`

### 验证
烧录后串口终端按方向键正常: 上/下切换历史命令, 左/右移动光标, 不再显示 `[A [B [C [D`。

### 教训
- **char 返回值不能区分 -1 和 0xFF**: getchar 类函数 (需用 -1 表示无数据) 必须返回 int, 不能用 char。这是 C 语言经典陷阱, char 隐式转换 int 时符号扩展/截断会丢失 -1 语义。
- **DMA 改造引入的回归**: 原 polling getchar 直接读 USART1->dt, 无数据时返回 -1 也是 char 截断 (但 polling 模式下不会在 ESC 序列中间返回 -1, 因为有字符才读)。DMA 环形 buffer 模式下 getchar 在任意时刻都可能返回 -1 (buffer 空), char 截断的 -1 变 255 破坏了方向键状态机。

---

## 开环拖动 sin 查表不连续: s_sin_table 仅 244 元素 — 2026-06-26

### 记录编号
S5-DBG-003

### 调试目标
排查开环拖动模式下 sin(theta) 在 theta 从 6.01 rad 到 0 阶段正弦值均为 0、波形不连续的问题。

### 现象
- 开环拖动模式，theta 从 6.01 rad 下降到 0 的过程中，foc_sin_f 返回值持续为 0
- 波形在 theta ≈ 6.01 rad 处出现"跳崖"式不连续，理论上 sin 应是平滑过渡

### 根因分析

#### 代码定位
查表函数 `foc_sin_f()` 的执行路径：

```
theta ≈ 6.01 rad → norm = fmodf(theta, 2π) ≈ 6.01
fidx = norm × 256 / 2π ≈ 6.01 × 40.7437 ≈ 244.87
idx0 = (uint32_t)244.87 = 244
idx1 = (idx0 + 1) & 0xFF = 245
frac = 0.87

v0 = s_sin_table[244] = ?
v1 = s_sin_table[245] = ?
```

#### 直接原因
s_sin_table 数组声明为 `static const float s_sin_table[TRIG_TABLE_SIZE]` 即 `[256]`，但初始化列表**只提供了 244 个**浮点数字面量（检查 `foc_core.c` 第 25-57 行的初始化器列表，实际元素数仅 244）。

C 标准（C90 §6.5.7 / C99 §6.7.8）规定：
> 如果初始化器提供的值少于数组元素个数，剩余元素被**隐式零填充**。

因此：
- `s_sin_table[0..243]` = 提供的值（部分也存在精度不足的问题，但至少非零）
- **`s_sin_table[244..255]` = 0.0f** ← 这就是 sin 为 0 的根因

正常第 245 元素（索引 244）应为 `sin(2π × 244/256) = sin(5.9855) ≈ -0.195090`，实际为 0.0。

### 根本原因
**Agent / AI 工具盲目生成代码**：设计规格明确要求 256 点查表（`TRIG_TABLE_SIZE = 256`），但自动生成的初始化列表只生成了 244 个值就被截断。开发者未对生成的查表数组做长度校验，编译也未报错（C 标准允许部分初始化），导致这个"静默截断"缺陷被带入固件。

### 引发的连锁调试成本
这个隐蔽的 bug 导致了一系列后续误导性的调试投入：
1. **怀疑 sin 查表函数的归一化/插值算法** → 审查 `foc_sin_f` 的 `fmodf`、线性插值逻辑 → 无问题
2. **怀疑 theta 角度的生成逻辑**（开环斜坡、编码器读取） → 审查角度更新路径 → 无问题
3. **怀疑编译器优化导致查表异常** → 添加 `volatile`、调试快照 → 仍异常
4. **新增串口调试输出**（sin/cos Q15 写入 `mc_debug`） → 最终暴露 sin 值为 0

**这些排查原本都可以避免**，如果生成代码后做一项简单的检查：确认初始化列表的元素数量等于数组声明长度。

### 修复

**根因修复**：`foc_core.c` s_sin_table 补全为完整的 256 点正确值（第 245 项以后不再为零填充）。

**连带改动**：
- `motor_control_isr.c`: s_sin / s_cos 加 `volatile` + 添加调试快照变量，防止调试器优化
- `motor_control_isr.h`: 调试结构体增加 sin_q15 / cos_q15 字段，通过 `mc_debug` 命令可见
- `motor_shell.c`: `mc_debug` 增加 sin/cos Q15 定点值显示，便于串口观测

### 处理措施
1. 重新生成完整的 256 点 sin 表（使用 Python/C 生成脚本，保证数学正确性）
2. 逐项核对确认 256 个值完整无缺
3. lib 层增加编译期断言，确保查表数组长度与 TRIG_TABLE_SIZE 一致：
   ```c
   STATIC_ASSERT(sizeof(s_sin_table) / sizeof(s_sin_table[0]) == TRIG_TABLE_SIZE);
   ```
4. 所有未来自动生成的数组初始化列表，必须附加"元素计数校验"步骤

### 验证方法
- 编译通过（无 zero-fill 告警）
- `mc_debug` 输出 sin_q15 在 theta 全范围非零且连续变化
- 示波器查看开环拖动模式下三相 PWM 波形连续无跳变

### 结论
**罪魁祸首：Agent 生成的 sin 表只有 244 个元素，C 标准零填充了剩余的 12 个元素为 0.0**。这是一个"生成的代码静默出错、编译不报错、运行才暴露"的典型 AI 生成代码陷阱。

### 踩坑总结
1. **数组初始化列表必须计数校验**：任何时候声明一个固定大小的数组并用初始化列表填充，都应验证元素数是否等于数组长度。C 编译器对这种"少填"行为零报错（合法语法），后果只能运行时暴露。**建议在自动生成代码后立即加 `static_assert` 或元素计数检查**。
2. **AI 工具的数字细节需人工复核**：Agent 可在高层逻辑（算法框架、接口设计）上表现优秀，但在精确数据生成（如 256 个浮点数序列）上容易截断/遗漏。此类任务应:
   - 使用脚本生成数据（Python 生成 256 点→C 数组格式→`#include` 或 `xxd` 嵌入）
   - 或用 `static_assert` 编译期保护
3. **零填充是 C 静默陷阱**：`int arr[100] = {1,2,3};` 编译通过、链接通过、零 warning，但 arr[3..99]=0。如果业务逻辑依赖完整初始化，这就是定时炸弹。查表类数组尤其致命。
4. **调试路径的误导性**：问题表象在 sin 值突变为 0 → 自然怀疑算法/角度/优化 → 每条路排查一圈后才回到数据本身。如果最初有编译期长度断言，整个调试链条可以缩短到 0。

### 照片/波形/日志文件
- `foc_core.c` line 25-57: s_sin_table 初始化列表（修复后为 256 项）
- `motor_control_isr.h`: 调试结构体新增 sin_q15 / cos_q15
- `motor_shell.c`: mc_debug 显示 sin/cos 定点值

### 下一步
- 注意后续所有数组生成类任务均使用 Python 脚本生成 + `static_assert` 防御

## MA600A 磁编读取与标定重构 - 2026-06-30

### 目标
消除 `ma600a_debug_poll()` 与 FOC ISR 并发读 SPI2 的风险，建立 `encoder_service` 唯一快照源，并重构标定采集为消费 accepted snapshot。

### 验证重点
- 静止时 `enc_status` 的 `spike`/`bus` 计数不增长。
- FOC ISR 运行时 `encoder` 与 `enc_status` 读取同源。
- 标定期间每 tick 最多一次 MA600A SPI 事务。
- manual/auto 两种标定入口可用。

## 编码器标定加速与 msh 接口收口 - 2026-07-10

### 背景
复查 `application/motor_control/motor_calibration.c` 后确认当前旁轴磁编标定流程为正反恒速拖动对消法：

1. ALIGN 获取 `mech_zero_raw`。
2. 开环正转采集 `raw16` 直方图。
3. 开环反转采集 `raw16` 直方图。
4. 正反平均生成 256 点校正表。
5. 质量通过后写入 FLASH 标定区。

讨论结论：该标定策略不只适用于旁轴布局，同轴布局也可使用；区别是同轴安装几何误差通常更小，收益可能较低。为了保持软件链路一致，暂时保留相同标定策略。

### 参数调整
原参数为每方向 5 机械圈、60 electrical rpm，因 `MOTOR_POLE_PAIRS=7`，实际每方向需要 35 电角圈，标定总时间约 70s。

本次按调试需求缩短标定时间：

| 参数 | 修改前 | 修改后 |
|---|---:|---:|
| `CAL_MECH_TURNS_PER_DIRECTION` | 5 | 2 |
| `CAL_SPIN_SPEED_RPM` | 60 electrical rpm | 200 electrical rpm |
| `CAL_SPIN_DURATION_MS` | 35000 ms | 4200 ms |
| `CAL_SPIN_TIMEOUT_MS` | 50000 ms | 8000 ms |

计算依据：

```text
2 mechanical turns × 7 pole pairs = 14 electrical turns
200 electrical rpm = 3.333 electrical turns/s
14 / 3.333 ≈ 4.2 s / direction
```

自动标定总时长约：

```text
ALIGN 0.5s + FWD 4.2s + REV 4.2s + compute + flash ≈ 10s
```

### msh 指令整理
删除旧的重复标定入口，统一使用 `enc_*` 编码器接口。

保留/新增：

| 命令 | 用途 |
|---|---|
| `enc_zero [raw16]` | 查看/设置编码器零点，同时显示 ALIGN 采样 raw |
| `enc_cal_start [auto|manual]` | 启动编码器标定 |
| `enc_cal_stop` | 停止手动采集 |
| `enc_cal_status` | 查看标定状态、进度和质量指标 |
| `enc_cal_dump` | 打印 256 点标定表 |
| `enc_cal_erase` | 擦除 FLASH 标定区 |

删除导出：

```text
mc_zero
mc_calibrate
mc_cal_status
mc_cal_dump
mc_cal_erase
```

同步更新 `tests/stage4_bench.py` 与 `tests/stage5_bench.py`，台架脚本使用新的 `enc_*` 命令和 30s 标定超时。

### 代码改动
- `application/motor_control/motor_params.h`
  - 标定圈数/速度/时长参数改为 2 圈、200 electrical rpm。
- `application/motor_control/motor_calibration.h`
  - 修正注释：标定状态切换由 `motor_calibration_poll()` 按旋转时间推进，不再按样本数切换。
- `application/motor_shell.c`
  - 合并标定状态/质量输出到 `enc_cal_status`。
  - 合并表 dump 到 `enc_cal_dump`。
  - 合并 FLASH 擦除到 `enc_cal_erase`。
  - `mc_cur` 的提示改为 `enc_cal_start auto`。
- `application/motor_control/motor_control_isr.c`
  - 更新旧注释中的 `mc_calibrate` 名称。
- `tests/motor_control/test_calibration_shell_static.py`
  - 新增静态测试，检查快速标定参数与旧 msh 命令不再导出。

### 验证
已运行：

```text
calibration shell static tests passed
encoder math tests passed
python syntax ast parse passed
```

尝试运行固件构建：

```text
cmake --build build
```

当前 Windows shell 环境未找到 `cmake`，因此未完成本地 C 构建验证。需在具备 CMake/交叉工具链的环境或 Keil 工程中重新编译确认。

### 台架实测结果
加速参数下执行一次自动标定，结果：

```text
=== calibration ===
state     : 6 (DONE)
progress  : 100%
valid     : 1
max_resid : 115 mdeg (0.115 deg)
threshold : 1000 mdeg
quality   : samples=134424 bins=256 min_bin=420 residual=115 ok=1
spikes    : start=0 end=0 nonmono=0
```

分析：

- `samples=134424` 与预期一致：

  ```text
  4.2s × 2 directions × 16kHz ≈ 134400 samples
  ```

- `bins=256` 表示完整覆盖机械一圈。
- `min_bin=420` 表示最少箱也有足够样本。
- `max_resid=115 mdeg` 明显低于 1000 mdeg 阈值。
- `spikes=0`，本次采集未出现编码器跳变拒绝。

结论：本次 2 圈、200 electrical rpm 的加速标定在台架上通过质量门限，标定时长大幅缩短。

### 关于 raw16 与电角度周期的确认
调试过程中观察 `s_snapshot.raw16` 与换算后的角度曲线，初看以为电角度周期不完整。复查后确认：

- `raw16` 是机械角，范围 0..65535，对应机械一圈。
- `s_snapshot.elec_mrad` 是电角度，范围 0..6283 mrad。
- 当前 `MOTOR_POLE_PAIRS=7`，因此机械一圈必然对应 7 个电角周期。

换算公式在 `encoder_service.c` 中为：

```c
corrected = encoder_apply_calibration(raw);
mech_diff = (uint16_t)(corrected - s_zero_raw);
theta = ((float)mech_diff * (float)MOTOR_POLE_PAIRS * TWO_PI_F) / 65536.0f;
```

因此 raw16 一个机械周期对应 `elec_mrad` 约 7 个锯齿周期是正确现象，不应期待 1:1 周期。

注意：`s_snapshot.mech_mdeg` 不是电角度，它只是未校正 raw 机械角转换成的机械毫度：

```c
s_snapshot.mech_mdeg = raw * 360000 / 65536;
```

后续如果需要更直观地在示波/调试器中观察电角度，可增加一个 `elec_u16` 调试量：

```c
elec_u16 = ((uint32_t)(corrected_raw - zero_raw) * MOTOR_POLE_PAIRS) & 0xFFFF;
```

这样可用 0..65535 的同尺度波形直接对比 raw 机械角与电角度周期关系。

### 待关注
1. `max_resid` 当前表示生成表的最大补偿量/残差指标，可作为质量门限，但不是外部高精度基准下的绝对误差验证。
2. 当前正反恒速对消法依赖开环拖动稳定性；后续 Stage 6 速度环完成后，可用闭环恒速重标定进一步验证一致性。
3. ALIGN 采样逻辑中 `s_align_tick_cnt` 与 `ALIGN_SETTLE_MS` 的单位关系仍需复核，避免毫秒和采样 tick 混用影响零点相位。

## 2026-07-10 编码器速度估计波动调试

### 现象
编码器标定后角度数据目前看已经正常，但在开环拖动时，理论上电机速度应当比较均匀，调试输出中的速度量仍有明显波动。

本轮使用 J-Link 和串口 COM9 联调，重点确认两个问题：

1. 当前编码器角度读取频率是多少。
2. 速度估计到底是角度真的在抖，还是估计算法把量化噪声放大了。

### 当前代码逻辑
当前编码器采样路径为：

```text
TMR7_GLOBAL_IRQHandler
  -> encoder_service_acquire_once()
```

`encoder_service_acquire_once()` 由 TMR7 中断驱动，当前采样频率为 4kHz。

FOC 控制中断为 16kHz。也就是说，FOC 每 4 次中断才会拿到一次新的编码器角度样本。

原来的 `encoder_tracker` 逻辑更像一个简化 PLL/PI 跟踪器：

```text
encoder_tracker_update_sample(angle)
  -> 用角度误差更新 speed_est

encoder_tracker_tick()
  -> 每个 FOC tick 用 speed_est 外推 angle_est
```

这个逻辑可以做角度外推，但速度量对单点角度误差、采样相位和启停状态比较敏感。调试中还看到停止/重新启动后 tracker 速度可能保留上一段状态，因此开环拖动时速度波形会显得比实际更乱。

另外，`s_snapshot.speed_raw` 这个量也不能直接作为当前速度判断依据：运行采样路径主要读取角度，raw frame 中的速度字段并不总是同步更新，实测时它经常为 0。

### 调试判断
单次 raw 差分本身会有量化噪声：

```text
raw_delta = raw_now - raw_prev
```

在 4kHz 采样下，低速时每个采样周期只跨过少量 raw LSB，单点差分会把编码器量化、SPI 采样相位、校正表局部斜率都直接映射成速度抖动。

所以这次倾向于把速度估计从“单点/PLL 误差驱动”改成“校正后角度的固定窗口差分”：

```text
1. 每次 4kHz 编码器采样时，先得到 corrected_raw16。
2. 对 corrected_raw16 做 unwrap，得到连续机械角 corrected_unwrapped。
3. 保存最近 N 个样本。
4. 用 corrected_unwrapped[n] - corrected_unwrapped[n-N] 计算窗口平均速度。
5. 输出机械速度和电速度：

   speed_mech = delta_raw * 2pi / 65536 / (N * Ts)
   speed_elec = speed_mech * pole_pairs
```

当前准备使用 `N=32`，在 4kHz 下窗口约 8ms。这个窗口比单点差分平滑很多，但延迟仍在速度环可以接受的范围内。

### 已实测数据
修正速度比例系数后，重新编译、烧录并通过 COM9 读取 `enc_status`，得到以下结果。

静止状态：

```text
spd_elec : min=-497 max=245 mean=-105 stdev=241 mrad/s
trk_speed: min=-665 max=329 mean=-44  stdev=330 mrad/s
```

开环 60 rpm：

```text
theory   : -6283 mrad/s
spd_elec : mean=-6289 stdev=545 mrad/s
trk_speed: mean=-6343 stdev=627 mrad/s
```

开环 200 rpm：

```text
theory   : -20944 mrad/s
spd_elec : mean=-20848 stdev=2213 mrad/s
trk_speed: mean=-20870 stdev=1963 mrad/s
```

这组数据说明平均值已经基本贴近理论速度，主要问题从“比例/方向不对”收敛到了“速度估计抖动和滤波延迟怎么取舍”。

### 本轮发现的坑
窗口速度估计里一开始把 raw16 到 mrad 的比例常数写大了 1000 倍，导致串口输出速度直接变成不合理的大数。

后面把转换关系重新核对为：

```text
raw16 一圈 = 65536
机械角一圈 = 6283 mrad
RAW16_TO_MRAD_NUM = 6283
```

并增加静态测试锁住这个常数，避免后面再把 `rad`、`mrad` 和 `urad` 搅在一起。

### 后续处理方向
后续代码修改按下面方向推进：

1. `encoder_service` 内部维护 corrected raw、unwrap 和窗口速度估计。
2. `encoder_tracker` 只负责角度外推，速度直接使用 `encoder_service` 的窗口估计结果。
3. 在 `open_loop_start/stop`、`align_start/stop`、`current_start/stop` 等状态切换处 reset tracker，避免旧速度状态残留。
4. `enc_status` 增加 corrected raw、窗口 delta、机械速度、电速度输出，后续台架调试直接看这几个量。

目前这部分代码已经完成初步实现和台架验证，但还没有单独提交；前面已先把 V2 BSP 硬件映射单独提交，避免两类改动混在一起。

## 2026-07-10 Stage 6 最小速度环实现记录

### 目标
在编码器角度和窗口速度估计已经基本稳定后，先实现最小版本速度闭环，不引入位置环、CAN 控制和复杂台架脚本。

本轮范围固定为：

```text
mc_speed <rpm_elec>
  -> speed_loop PI
  -> Iq_ref
  -> current_loop
  -> IPark/SVPWM
```

### 代码方案
新增/补全 `speed_loop`：

- 速度环目标单位为电角速度 `rad/s`。
- `speed_loop_run(measured_rad_s)` 输入窗口速度估计结果。
- 内部每 16 个 FOC tick 更新一次 PI，即 16kHz / 16 = 1kHz。
- PI 输出 `Iq_ref`，限幅到 `+-IQ_MAX_A`。
- 目标速度带斜坡，当前初值为 `600 rad/s^2`，避免 `mc_speed` 目标突变直接冲击电流环。

ISR 中新增 SPEED 分支：

- 角度使用编码器电角度 `s_enc_theta_e`。
- 速度反馈使用 `encoder_tracker_get_speed_rad_s()`，当前来源是 `encoder_service` 的 corrected raw 窗口速度。
- `speed_loop_run()` 得到 `iq_ref` 后调用 `current_loop_set_targets(0.0f, iq_ref)`。
- 后续 Clarke/Park/current_loop/IPark/SVPWM 流程复用 CURRENT 模式。

msh 新增：

```text
mc_speed <rpm_elec>
```

并扩展 `mc_debug`：

```text
spd: active/hits/target/cmd/meas/iq_ref
```

### 验证
已运行：

```text
python tests/motor_control/test_speed_loop_static.py
python tests/encoder_service/test_encoder_speed_static.py
python tests/encoder_service/test_encoder_calibration_math.py
project\MDK_V5\build.bat
```

结果：

```text
speed loop static tests passed
encoder math tests passed
MDK: 0 Error(s), 0 Warning(s)
Program Size: Code=39204 RO-data=4840 RW-data=560 ZI-data=10296
```

注意：主机 C 数学测试 `tests/motor_control/test_speed_loop.c` 已添加，但当前 Windows 环境未找到 `gcc`、`cl` 或 `clang`，暂未本地执行。目标侧编译由 Keil ARMCC 完成。

### 台架待测
下一步上板后先低风险验证：

```text
1. fault_clear
2. mc_cal
3. enc_cal_status 确认 valid=1
4. mc_speed 60
5. mc_debug / enc_status 观察 target/cmd/meas/iq_ref
6. mc_speed 200
7. mc_stop
```

重点看：

- 方向是否与 `mc_open` 一致。
- `meas` 是否能跟到 `target` 附近。
- `iq_ref` 是否被限幅在 `+-IQ_MAX_A`。
- `mc_stop` 后 MP6540H EN 是否关闭、PWM 是否回到 50%。

## 2026-07-10 电流环补测与保护误触发排查

### 背景
准备测试 Stage 6 速度环时发现 `mc_speed` 很快进入故障，进一步确认前面的电流环还没有形成完整台架验收结论，因此暂停速度环，先回到 Stage 5 电流环补测。

### 先遇到的保护误触发
测试 `mc_speed 60`、`mc_speed 10` 和 `mc_cur 50 enc` 时，多次出现：

```text
fault = 0x00000008
  UNDERVOLTAGE
```

但同一时间 `mc_debug` 和 `vbus` 看到的 VBUS 都在 12.1V 左右：

```text
vbus : 12118..12152 mV
```

排查代码后确认，FOC ISR 内每 1ms 软件触发一次 ADC2 ordinary conversion 读取 VBUS，而 ADC2 同时承担 TMR1_CH4 触发的注入电流采样。普通转换在 ISR 内会和注入序列冲突，出现超时或低值假样本，随后被欠压保护锁存。

处理措施：

1. 对 VBUS 欠压/过压先尝试加连续样本 debounce，但仍会误触发。
2. 最终把 VBUS ordinary ADC 软件触发从 FOC ISR 移除。
3. ISR 内暂时使用 `VBUS_FALLBACK_V=12V` 缓存参与 SVPWM 计算。
4. `vbus` shell 命令仍可人工读取母线电压。

这个处理让电流环测试不再被 VBUS 误故障打断，但也意味着运行时 VBUS 保护需要后续单独设计到低频线程或更可靠的硬件触发路径，不能长期停留在这个临时方案。

另一个保护误触发点是相过流单拍锁存。测试中曾出现 `iq_ref` 很小但 `OVERCURRENT` 被锁住的情况，快照电流并不大。现已给相过流增加短 debounce：

```text
OVERCURRENT_DEBOUNCE_TICKS = 4
```

也就是 16kHz 下约 0.25ms。真实持续过流仍能快速保护，单拍 ADC 毛刺不会立即锁死。

### 电流环实测结果
前置条件：

```text
fault_clear
mc_cal
enc_cal_status: valid=1
vbus: 12.118V
```

电流零偏：

```text
offset OK: a=2059 b=2070 c=2071
offset OK: a=2068 b=2070 c=2072
```

#### ramp 模式
`mc_cur 50 ramp 60`：

```text
iq_ref = 50mA
id     = -54mA
iq     = -71mA
fault  = 0
```

`mc_cur -50 ramp 60`：

```text
iq_ref = -50mA
id     = -42mA
iq     = 54mA
fault  = 0
```

结论：ramp 调试角度源下 Iq 正负号和期望相反，后续需要复核 ramp theta 方向、Park 符号和相序约定。ramp 模式暂不能作为速度环前置验收依据。

#### enc 模式
`mc_cur 50 enc`：

```text
iq_ref = 50mA
id     = -64mA
iq     = 53mA
fault  = 0
```

`mc_cur 100 enc`：

```text
iq_ref = 100mA
id     = 95mA
iq     = 117mA
fault  = 0
```

`mc_cur 200 enc`：

```text
iq_ref = 200mA
id     = 39mA
iq     = -57mA
fault  = 0
```

结论：

- `50mA enc` 和 `100mA enc` 短时可运行，无过流、无欠压、无传感器故障。
- `200mA enc` 未跟住目标，Iq 方向/幅值异常。
- 输出电压在部分测试中接近限幅，说明 PI 参数、角度零点/方向、Park 符号或电流采样符号仍需进一步分解验证。

### 当前结论
电流环现在只能算“低电流 enc 模式初步跑通”，还不能算完整 Stage 5 台架验收通过。

继续速度环前，建议先完成：

```text
1. 固定 enc 模式测试矩阵: 50mA / 100mA / 150mA / 200mA。
2. 观察 Iq 是否单调跟随目标，Id 是否接近 0。
3. 复核 ramp 模式 Iq 正负号反向问题。
4. 重新设计运行时 VBUS 保护，不放在 FOC ISR 内做 ordinary ADC 软件触发。
```

### 2026-07-10 追加：电流采样触发点修复

在继续排查 `mc_cur` 不跟随目标的问题时，新增了 `cur_avg` 诊断量：

```text
cur_avg : id=<mA> iq=<mA> window=256
```

窗口为 256 个 FOC tick，约 16ms。复测发现默认 CH4=1 时，`iq_avg` 基本贴近 0mA，不随 `iq_ref=+/-50/100/200mA` 变化；但 PI 输出电压和 PWM duty 已经明显变化。这说明问题不是 `mc_debug` 单点快照抖动，而是电流反馈在默认采样点没有读到有效相电流。

随后用新增命令扫描 ADC 注入触发点：

```text
pwm_adc_trig <ticks>
```

ALIGN 固定电压下的结论：

- CH4=1..2000：三相电流基本只在零点附近跳动，随 ALIGN 电压不明显增加。
- CH4=2500..3000：开始读到明显电流响应。
- CH4=4000 以后：读数有较大固定偏置，Park 后 Id/Iq 容易进入错误象限。

进一步用 `CH4=2500` 做 enc 电流环复测：

```text
iq_ref=  50mA -> iq_avg ~=   51mA
iq_ref= 100mA -> iq_avg ~=   97mA
iq_ref= 200mA -> iq_avg ~=  199mA
iq_ref= -50mA -> iq_avg ~=  -49mA
```

因此将默认 ADC 触发点从谷底 `1` 改为 `2500` ticks，并保留 `pwm_adc_trig` 作为后续台架/示波器微调接口。`pwm_info` 当前应显示：

```text
CCR4 : 2500 (ADC trigger)
```

本次修复后，正向低电流和小负向电流已能闭环跟随；但 `-100mA/-200mA enc` 仍会跑到约 `id_avg=850mA, iq_avg=320mA` 的异常工作点。当时误将 MP6540H 低边导通窗口采样判断为“高边电流镜”，因此把异常归因于负向较大电流/不同 PWM 象限下的采样窗口或重构策略；该判断已在 2026-07-21 的极性实测中更正，实际根因是器件电流方向与 FOC 相电流约定相反。

当前建议：

```text
1. Stage 6 速度环先只按正向低速/低电流做受控验证。
2. 负向速度环或双向力矩控制前，继续处理负向较大 Iq 的采样/重构问题。
3. 保留 cur_avg 和 pwm_adc_trig，后续配合示波器确认 SOA/SOB/SOC 有效窗口。
```

## 2026-07-20 电流采样重构固件上板预检

日期：2026-07-20
记录编号：2026-07-20-CS-RECON-HW-01
阶段：阶段 5，电流采样窗口判定与三相重构
目标：烧录提交 `bf26919`，确认新固件安全启动并完成闭环给流前置检查。
硬件版本：当前 AT32M412 + MP6540H + MA600A 板卡，具体板号待补。
固件版本/提交号：`bf269193306ad23b3f80da28c22fa5dbd0c9e6ff`
供电条件：实测 VBUS=12.152V；电源限流设置尚未确认。
电机/负载：已连接状态与负载条件待用户确认。
仪器：J-Link V9（S/N 20721552，VTref=3.287V）、COM9 115200；示波器连接尚未确认。
连接方式：J-Link SWD 1000kHz；USART1 COM9 115200 8N1。
操作步骤：先经 COM9 执行 `mc_stop` 并检查状态；Keil 全量构建；J-Link 原生命令行选择 `AT32M412KBU7-4` 后执行 reset/halt/loadfile/reset/go；最后查询 `mc_state`、`fault`、`pwm_info`、`enc_cal_status`、`mc_current`、`mc_debug`、`vbus`。
观察结果：Keil 构建 0 Error/0 Warning。Keil `UL2CM3.DLL` 下载路径报 `Internal DLL Error`；改用 SEGGER J-Link Commander 后擦除、编程和 Verify 均完成，写入 48128 bytes，返回 `O.K.`。新固件启动后 state=0（DISABLED）、mode=0、fault=0、CCR1/2/3=2812、CCR4=5264、EN(PB10)=0、编码器标定 valid=1、VBUS=12.152V。电流零偏 valid=0，符合尚未执行本次上电 `mc_cal` 的状态。
异常现象：Keil 下载 DLL 路径失败；探针枚举、SWD DAP、CPUID 读取和 SEGGER 原生下载均正常，问题限定在 Keil 下载集成层。一次使用重定向输出调用 J-Link 时宿主等待超时，随后用官方 command-file 模式重烧并 Verify 成功。
初步判断：固件、J-Link 探针、SWD 目标链路均正常；Keil 下载失败为工具集成问题，不影响使用 J-Link Commander 烧录。
处理措施：全过程保持 `mc_stop`、MP6540H EN=LOW；绕过 Keil 下载 DLL，使用 J-Link Commander 原生烧录并校验。
验证方法：烧录后从 COM9 读取新代码特有的固定触发点 `CCR4=5264`，同时核对安全默认态、故障、编码器标定和 VBUS。
结论：新固件已可靠上板且安全启动；尚不能宣称全象限电流闭环通过。
照片/波形/日志路径：`project/MDK_V5/keil_flash.log` 记录 Keil 下载失败；J-Link Commander 成功日志保存在本次 Codex 终端记录中。
下一步：确认限流电源设置，并用示波器核对一相 PWM、CH4=5264 触发及对应 SOx 有效窗口；门禁通过后执行 `mc_cal` 与 ±50/100/200/500mA 自动矩阵。

### 追加：1A 限流下低电流闭环验证

供电与安全条件：用户确认电源限流 1A；示波器只有两通道，本轮未完成 PWM、CH4、SOx 三信号同时观测，因此不记为示波器门禁通过。自动矩阵仍限制在 ±500mA，并在首点失败后停止。

Section A 结果：

- `mc_cal` 成功，offset=`a=2062 b=2064 c=2072`，offset_valid=1。
- 编码器标定 valid=1。
- 启动前 state=DISABLED、fault=0。

自动矩阵在第一个 `-50mA enc` 点失败。为了定位无文本断言，单独复现并读取三组快照：

```text
目标 Iq=-50mA
Id_avg ≈ -647...-656mA
Iq_avg ≈ +569...+576mA
valid_mask=0x07
invalid_total=0, invalid_consecutive=0, pi_freeze=0
fault=0
```

随后只测对称的 `+50mA enc`：

```text
目标 Iq=+50mA
Id_avg ≈ -460...-464mA
Iq_avg ≈ -699...-706mA
valid_mask=0x07
invalid_total=0, invalid_consecutive=0, pi_freeze=0
fault=0
```

两种极性都进入与目标相反的大电流工作点，且采样有效、无冻结、无故障，说明不是无效帧或单一负象限问题。将触发点临时设回 2500 后，窗口判断得到 `valid_mask=0x00`，第 8 帧准确锁存 `FAULT_CURRENT_SAMPLE=0x80` 并输出回到 50%，验证无效采样保护有效；随后恢复 CCR4=5264。

为确认相电流符号，执行固定小电压开环：

```text
mc_open 500 0
theta=0, Valpha=+500mV, Vbeta=0
CCR: A=2987, B=2636, C=2636
实测 corrected: Ia=-126...-343mA, Ib/Ic=+41...+173mA
valid_mask=0x07, fault=0
```

正 α 轴电压下理论相电流方向应为 `Ia>0, Ib/Ic<0`，实测整体相反。由此确认根因：固定 5264 采样位于三相低边导通窗口，MP6540H SOx 所给的低边器件电流方向与 FOC 的相电流正方向相反；当前重构完成了窗口判断、择相和 KCL 补相，但没有在进入 Clarke/Park 前统一转换低边采样极性，电流 PI 因此变成正反馈。

处置：停止 100/200/500mA 测试，不进入速度环；最终执行 `mc_stop`，确认 state=DISABLED、mode=0、fault=0、CCR1/2/3=2812、CCR4=5264、EN(PB10)=0。

下一步：在低边采样重构输出到 Clarke/Park 的唯一边界统一修正三相符号，补充极性单元/静态测试后重新构建烧录，从 `mc_open 500 0` 极性门禁开始复验，再运行 ±50/100/200/500mA 矩阵。

## 2026-07-21 低边采样极性修复与全象限复验

日期：2026-07-21
记录编号：2026-07-21-CS-POLARITY-HW-02
阶段：阶段 5，电流采样重构极性修复
目标：修正 5264 低边窗口电流与 FOC 相电流符号相反的问题，并复验 ±500mA 内全象限闭环。
硬件版本：当前 AT32M412 + MP6540H + MA600A 板卡。
固件版本/提交号：`314080c`（设计与计划 `ad5f3e0`）。
供电条件：母线约 12V，实验电源限流 1A。
电机/负载：当前已接电机，无额外负载信息。
仪器：J-Link V9（S/N 20721552）、COM9 115200；示波器仅两通道，本轮仍不记为三信号同时观测门禁。
连接方式：J-Link SWD 1000kHz；USART1 COM9 115200 8N1。

### 软件修复与验证

在 `current_reconstruction_run()` 内保留 `raw_ia/raw_ib/raw_ic` 的低边器件电流极性，只对提供给保护、Clarke/Park 和 corrected 诊断的 `ia/ib/ic` 统一取反，再从归一化后的两相重构第三相。

TDD 证据：新增低边样本 `raw=(-0.30,+0.10,99.0)` 的主机测试，旧实现按预期在极性断言失败；三行最小修复后输出 corrected `( +0.30,-0.10,-0.20 )`，focused 测试打印 `current reconstruction: all tests passed`。

软件全量验证：

- 所有仓库 `*_static.py` 脚本通过，Stage 5 bench parser 回归通过。
- 严格 `-std=c11 -Wall -Wextra -Werror` 主机测试：重构通过，current loop 6/6，speed loop 5/5。
- CMake ARM 构建到 100%，FLASH=73680B/127KB，RAM=11360B/16KB。
- Keil clean build：Code=42828，0 Error(s)，0 Warning(s)。
- GCC 构建仍有既有 FinSH 导出宏警告，与本修复无关。

### 烧录与极性门禁

SEGGER J-Link Commander 擦除、编程和 Verify 48128 bytes，返回 `O.K.`。上电零偏标定结果：

```text
mc_cal result: PASS offset_valid=1 a=2061 b=2063 c=2072
encoder calibration valid=1
```

执行 `mc_open 500 0` 后三次 corrected 电流快照：

```text
Ia=343mA, Ib=-170mA, Ic=-173mA
Ia=129mA, Ib=-100mA, Ic=-28mA
Ia=119mA, Ib=-56mA,  Ic=-63mA
```

三次均满足正 α 轴电压下 `Ia>0, Ib<0, Ic<0`；对应 raw 电流保持相反硬件极性。采样均为 tick=5264、valid_mask=0x07，invalid_total=0、invalid_consecutive=0、pi_freeze=0、fault=0。

### ±50mA 独立门禁

```text
-50mA: Iq_avg=-48,-47,-50mA; Id_avg=0,-2,-1mA; fault=0
+50mA: Iq_avg=+49,+48,+48mA; Id_avg=0,0,0mA; fault=0
```

两点均无 invalid/freeze 增长，门禁通过后才运行完整矩阵。

### 自动八点矩阵

```text
PASS -50mA:  id=-5mA iq=-50mA mask=0x07 recon=1
PASS +50mA:  id=-1mA iq=+46mA mask=0x07 recon=2
PASS -100mA: id=0mA  iq=-99mA mask=0x07 recon=1
PASS +100mA: id=0mA  iq=+100mA mask=0x07 recon=3
PASS -200mA: id=0mA  iq=-200mA mask=0x07 recon=2
PASS +200mA: id=1mA  iq=+201mA mask=0x07 recon=1
PASS -500mA: id=0mA  iq=-500mA mask=0x07 recon=2
PASS +500mA: id=0mA  iq=+498mA mask=0x07 recon=1
=== ALL PASS ===
```

Iq 最大偏差 4mA，|Id| 最大 5mA；所有点均未出现 invalid/freeze 增长或致命故障。

最终安全状态：执行 `mc_stop` 后 state=DISABLED、fault=0、CCR1/2/3=2812、CCR4=5264、EN(PB10)=0。最终诊断计数 invalid_total=0、invalid_consecutive=0、pi_freeze=0。

结论：低边采样极性根因已修复，±500mA 范围内正负 Iq 全象限电流闭环通过。当前证据不覆盖 >500mA、±1.5A 最大能力或速度闭环。

照片/波形/日志路径：`tests/stage5_bench_log.txt`；软件与 J-Link 完整输出保存在本次 Codex 终端记录中。

下一步：如需扩大电流，按 +0.75/1.0/1.25/1.5A 和对应负向逐点人工验证，并受当前 1A 电源限流约束；速度环必须在扩大电流策略确认后另行验证。

### 追加：审查后权威日志复验

根据代码审查意见，`tests/stage5_bench.py` 增加最终安全状态的主动查询、断言和日志记录，并在每个电流点显式要求 sample_tick=5264、valid_mask=0x07。修改后重新运行完整八点矩阵：

```text
PASS -50mA:  id=0mA iq=-52mA
PASS +50mA:  id=1mA iq=+51mA
PASS -100mA: id=0mA iq=-98mA
PASS +100mA: id=0mA iq=+99mA
PASS -200mA: id=0mA iq=-198mA
PASS +200mA: id=0mA iq=+198mA
PASS -500mA: id=0mA iq=-499mA
PASS +500mA: id=0mA iq=+500mA
FINAL SAFE: state=DISABLED fault=0x00000000 en=0 ccr=2812/2812/2812 tick=5264 mask=0x07 invalid_total=0 invalid_consecutive=0 pi_freeze=0
=== ALL PASS ===
```

本轮 Iq 最大偏差 2mA，|Id| 最大 1mA。日志本身现已覆盖控制性能、采样窗口、诊断计数和最终硬件安全状态。

### 调试结案索引

- **结案日期**：2026-07-21。
- **根因**：MP6540H SOx 在低边导通窗口输出的是低边器件电流，其正方向与 FOC 相电流约定相反；重构结果未做极性归一化，使电流 PI 形成正反馈。
- **最终修复**：在 `current_reconstruction_run()` 的硬件/控制边界保留 `raw_ia/raw_ib/raw_ic` 原始极性，并将 corrected `ia/ib/ic` 统一取反后再进行 KCL 补相。
- **验证条件**：母线约 12V，实验电源限流 1A；J-Link 烧录，COM9 自动采集。示波器仅两通道，本次不把三信号同时观测列为验收证据。
- **验收范围**：`Iq_ref=±50/±100/±200/±500mA` 八点全部通过，最终权威复验的 Iq 最大偏差 2mA、最大 `|Id|` 1mA。
- **安全收尾**：`DISABLED`、`fault=0`、`EN=0`、`CCR1/2/3=2812`、`CCR4=5264`，采样掩码 `0x07`，无 invalid/freeze 累积。
- **软件证据**：严格主机 C 测试、仓库静态测试、ARM CMake 构建、Keil clean build 均通过；独立代码复审无 Critical、Important 或 Minor 遗留。
- **关键提交**：`314080c`（极性修复）、`92987d2`（硬件验证）、`83f3abe`（权威日志断言）、`eb2c0da`（八点复验记录）、`453df05`（清理历史误判措辞）。
- **未覆盖范围**：`|Iq|>500mA`、±1.5A 最大能力和速度环实机闭环，不能由本次记录外推为已通过。
- **结论**：Stage 5 电流环在 ±500mA 验证范围内完成正负全象限闭环；本次调试关闭。

## 2026-07-21 编码器方向修复与速度环台架调参

日期：2026-07-21
记录编号：2026-07-21-SPEED-HW-01
阶段：阶段 6，速度闭环恢复与空载性能调试
硬件：AT32M412 + MP6540H + MA600A，V2 电机，轴完全自由
供电与接口：VBUS 约 12.1V，J-Link V9 SWD 1000kHz，COM9 115200

### 根因与方向门禁

正向开环 `mc_open 1000 +60 ramp` 时 MA600A raw 递减，反向命令时 raw 递增；原实现直接使用 `position-zero` 和 raw unwrap 速度，导致控制电角度和速度反馈方向均与正向电场相反。表现为 `mc_cur` 只移动约一个小角度后形成“电磁弹簧”，`mc_speed` 则形成正反馈并请求最大 Iq。

修复后统一使用 `MOTOR_ENCODER_DIRECTION=-1` 归一化控制角度与窗口速度，raw/corrected unwrap 仍保留硬件方向作为诊断。实机方向门禁：

```text
mc_open 1000 +60 ramp -> spd_elec=+6706mrad/s, fault=0
mc_open 1000 -60 ramp -> spd_elec=-7378mrad/s, fault=0
```

`mc_cur ±50mA enc` 随后可连续正反加速，不再停在小角度弹簧平衡点。由于自由轴会持续加速并最终受反电势/电流环 ±2V 电压限幅约束，旧 Stage 5 脚本“每个恒流点等待数秒后仍保持目标电流”的台架条件不再适用于修正方向后的自由旋转工况；此前静止/受限条件下已完成的 ±500mA 电流环验收结论不变。

### 最终速度环配置

```text
encoder speed window : 16 samples @ 4kHz = 4ms
speed loop rate      : 1kHz
Kp accelerate        : 0.01
Kp overspeed brake   : 0.04
Ki                   : 0.01
friction feedforward : +/-20mA (zero command = 0)
target ramp          : 50rad/s^2
speed Iq limit       : +/-0.5A
```

控制器在同向超速时禁止继续输出同向加速电流，允许零电流滑行或反向制动。该约束解决了摩擦补偿和积分在已经超速时仍短时维持正扭矩的问题。测试脚本在各目标之间使用 `mc_speed 0` 主动制动到低速并再 `mc_stop`，避免自由轴惯性污染下一组阶跃；同时对运行时偶发 UART 坏字节做 ASCII 丢弃、有限重试和目标状态确认。

### 最终硬件结果

最终选择候选 21，四点各运行 5 秒：

```text
+10rpm_e : target=1047,  steady=2009, direction OK, peak Iq_ref=76mA
+60rpm_e : target=6283,  steady=6202, error=1.29%, peak=144.2%, Iq_ref<=97mA
-60rpm_e : target=-6283, steady=-6034, error=3.96%, peak=144.2%, Iq_ref<=91mA
+200rpm_e: target=20943, steady=20300, error=3.07%, peak=112.1%, Iq_ref<=100mA
```

所有点 `invalid_delta=0`、`freeze_delta=0`、`fault=0`，峰值 `|Id|=23mA`。最终安全态为 `DISABLED`、`fault=0`、`EN=0`、`CCR1/2/3=2812`、`CCR4=5264`、`speed_active=0`。

Clean build 产物再次烧录后的重复矩阵得到：+60rpm_e 误差 2.72%、峰值 130.8%；-60rpm_e 的 1 秒末窗误差 14.66%、峰值 120.1%；200rpm_e 误差 0.51%、峰值 114.5%。随后单独延长 -60rpm_e 到 10 秒，2–5 秒、5–8 秒、8–10 秒中位速度分别为 -6286、-6034、-6370mrad/s，说明平均速度已围绕 -6283mrad/s 目标收敛，但瞬时速度仍在约 -2.3 至 -9.2krad/s 范围随齿槽相位波动。Stage 6 严格脚本因此保持非零退出，不把低速点误记为通过。

结论：编码器方向根因已修复，速度环正反方向功能恢复，200rpm_e 空载性能可重复通过误差 <5% 和峰值 <120% 门禁；±60rpm_e 的长窗平均速度接近目标，但 1 秒末窗误差与瞬时峰值不能稳定通过门禁。60rpm_e 对 7 极对电机仅为 8.6rpm_mech，当前主要限制是空载齿槽/低速速度纹波，不能外推为超低速性能已结案。位置环开发应以本速度环参数为安全内环起点，并单独设计低速/静止保持策略。

关键提交：`3044b6d`（方向归一化）、`a403e12`（速度模式 0.5A 限流）、`bf37ed1`/`89a6d2b`/`18478bb`（速度台架与通信鲁棒性）、`c9b4a73`（低惯量速度控制调参）。

## 2026-07-21 低速纹波分层诊断与串口完整性修复

记录编号：2026-07-21-SPEED-HW-02

基线提交为 `281d056`。本轮保持电机轴完全自由，先区分编码器校正、测速带宽、控制策略和串口采集四个因素。

### 根因排查证据

- 板上 256 点校正表范围为 -65..+49mdeg，相邻点最大变化 -87..+65mdeg；折算速度比例因子为 0.9538..1.0619，标准差 0.84%。校正表求导会贡献少量纹波，但不足以解释约 40% 的低速瞬时变化。
- 校验有效的 +60rpm_e 15 秒采样中，4ms 反馈标准差约 1247mrad/s；由相邻 raw16 在约 50ms 上直接差分得到的轴速标准差约 691mrad/s。3/5 个串口周期聚合后标准差约 565/490mrad/s，确认短窗测速放大了真实齿槽/低速脉动，但并非全部为估计噪声。
- 同一 15 秒数据的末 1/3/5/10 秒中位误差分别为 1.29%/3.96%/3.96%/1.29%；P90/P95/P99 瞬时速度分别为目标的 120.1%/125.4%/144.2%。因此平均稳速已进入 5%，而 4ms 瞬时峰值门禁仍不稳定。

### 被硬件否定的两个单变量候选

1. 测速窗从 16 点/4ms 增至 32 点/8ms，其余参数不变：+60/-60/+200rpm_e 稳态误差分别恶化到 18.56%/28.64%/15.91%，峰值为 196.2%/235.0%/151.4%。确认新增相位延迟不可接受，已撤回。
2. 同向超速时绕过积分和摩擦前馈、立即输出纯 P 制动：+60rpm_e 稳态误差恶化到 46.63%，+10rpm_e 出现方向错误；+200rpm_e 仍为 1.47%/118.6%。确认 4ms 纹波下主动反扭矩会放大低速极限环，已撤回。

最终固件控制算法与 `c9b4a73` 基线一致：16 点测速窗、Kp=0.01、超速 Kp=0.04、Ki=0.01、20mA 摩擦补偿、50rad/s^2 斜坡和 0.5A 限流。

### COM9 静默截断修复

原 `spdstat` 使用可变宽数字且无完整性检查。实测坏字节可把 `enc=25062` 截成 `enc=250`，旧正则仍会接受；新增长字段又证明 finsh 单行缓冲会把尾部稳定截断。最终将状态行压缩为 `ss a=... t=...`，并对全部数值字段、编码器 raw16 和固定种子 `0x53504436` 做 uint32 异或校验，输出 `k=XXXXXXXX`。主机仅接受校验一致的完整行，否则自动重试。

校验协议固件矩阵结果：+60rpm_e 的 1 秒末窗误差 20.10%、峰值 133.5%；-60rpm_e 误差 3.96%、峰值 125.4%；+200rpm_e 误差 0.91%、峰值 118.6%。全程 `invalid=0`、`freeze=0`、`fault=0`，最终 `DISABLED`、`EN=0`、三相 50%、CCR4=5264。

随后用校验遥测采集正反多圈 `Iq_ref(raw16)`。±200rpm_e 各约 12 秒时，28/32 桶正反相关仅 0.24，正向前后半程相关约 0.21/0.24；±60rpm_e 各约 25 秒时，14/28/32 桶正反相关分别为 0.09/0.39/0.21，其中 28 桶推导图 RMS 约 12mA、峰值约 21mA，与闭环调节噪声同量级。静态齿槽图缺乏方向间和时间上的重复性，本轮不进入前馈实现，避免把闭环噪声学习成位置表。

结论：中高速速度环和低速长窗平均速度可用；8.6rpm_mech 量级的瞬时纹波不能再靠增加测量延迟、提高制动力或静态齿槽表解决。工程早期单点 PLL 已因量化噪声敏感和启停状态残留被窗口差分替代；若继续追求超低速瞬时性能，应设计保留 4ms 快速反馈、同时分离低频状态估计或限制扭矩变化率的双带宽结构，并保留当前参数作为安全回退基线。

## 2026-07-21 单电机位置+速度前馈台架验收

日期：2026-07-21
记录编号：2026-07-21-POS-HW-01
阶段：阶段 7，单电机位置闭环
硬件版本：AT32M412 + MP6540H + MA600A，V2 电机
固件版本/提交号：`40849d9`
供电条件：VBUS 约 12V，位置级联 `|Iq_ref|<=0.5A`
电机/负载：单电机空载，轴完全自由
仪器与连接：J-Link V9 SWD 1000kHz，COM9 115200

实现位置外环 Kp=5.0，电气速度上限 200rpm；速度非零时增加 40mA POSITION 专用摩擦前馈，静态误差超过 0.2deg 时使用 80mA。该前馈只在位置模式生效，独立速度环参数保持不变。流点含机械位置 mdeg、速度 mdeg/s、16位序号和 lease；100ms 断流后冻结参考、速度前馈清零并继续保持。

三轮完整重复结果：

```text
run1: sine P95=1.389deg, static max=0.314deg, reversal max=0.291deg
run2: sine P95=1.351deg, static max=0.254deg, reversal max=0.280deg
run3: sine P95=1.335deg, static max=0.314deg, reversal max=0.272deg
clean-build flash repeat: sine P95=1.329deg, static max=0.279deg, reversal max=0.222deg
```

所有反转测试采样到的过冲为 0；峰值 Iq_ref 小于 0.37A。每轮 timeout 均满足前馈归零、参考冻结和恢复；`invalid_delta=0`、`freeze_delta=0`、`fault=0`。最终状态均为 DISABLED、EN=0、CCR1/2/3=2812、CCR4=5264、speed_active=0、position_active=0。ARMCC5 clean build 为 0 Error/0 Warning，Code=46356、RO=5608、RW=668、ZI=10324。

COM9 是带回显的文本调试链路，状态采集会占用带宽；资格脚本以 20ms 名义点周期、按实际点间隔推进轨迹并报告约 31–38Hz 有效点率，不能把它当作 100Hz CAN 时序证据。控制 API、20ms 外推和 100ms lease 均按未来 100Hz CAN 设计。

结论：单电机已达到五连杆上机构前的可用门禁。当前轨迹误差已达标，不需要先加入齿槽表或扭矩脉动补偿。下一步实现电机侧 CAN1 收发/协议与 X-Track `CanMotorTransport`，再验证双节点同步、100Hz 实时点率和机构负载下误差。

## 2026-07-21 MotorDriver CAN 节点开发与 Node 1 预配置

日期：2026-07-21
记录编号：2026-07-21-CAN-NODE-01
阶段：阶段 8，MotorDriver 双节点 CAN 轨迹接口
硬件版本：AT32M412 + MP6540H + MA600A，V2 电机
软件基线：从单电机位置环提交 `40849d9` 继续开发，当前资格基准为 `2a9a004`
供电与接口：VBUS 约 12V；J-Link V9（S/N 20721552）；COM9 115200；CAN1 PA12 TX / PA11 RX
本轮范围：电机侧协议、关节坐标持久化、CAN 驱动、同步运动状态机、诊断与无对端故障安全；不包含 X-Track 对端运动和双电机机构测试。

### 这次不是简单加一个“设置角度”命令

Stage 7 已经证明单电机的位置+速度前馈接口可用，但 COM9 是带回显的文本调试链路，实测有效点率只有约 31–38Hz。五连杆需要两个独立驱动板在同一时刻应用同一轨迹点，所以电机侧不能只做一个“收到位置就立刻执行”的 CAN 命令。

最终控制流冻结为：

```text
X-Track DISCOVER
        ↓
MotorDriver READY + health
        ↓
X-Track ARM(session)
        ↓
Node 1/2 分别接收 position + velocity + sequence 预装点
        ↓
X-Track 广播 SYNC(session, sequence)
        ↓
两个节点在各自 1kHz 服务节拍应用同一序号
        ↓
100Hz feedback + 20Hz health 返回 X-Track
```

这里把“轨迹数据”和“开始执行”拆成两步。轨迹帧只预装，匹配 session 和 sequence 的广播 SYNC 才允许生效。这样即使 Node 1 比 Node 2 早收到一帧，也不会提前起跑。

### 最终 CAN 协议边界

使用 Classic CAN、11-bit 标准帧、固定 DLC=8、1Mbps。正式协议以 `communication/can_protocol.h/.c` 和 `docs/superpowers/specs/2026-07-21-dual-node-can-trajectory-design.md` 为准。

| 类型 | CAN ID | 周期/用途 |
| --- | --- | --- |
| 广播控制 | `0x080` | ARM、SYNC、STOP、CLEAR_FAULT、DISCOVER |
| 节点轨迹 | `0x100 + node` | 位置 mdeg、速度 10mdeg/s、16位 sequence |
| 节点反馈 | `0x180 + node` | 实际位置、实际速度、applied sequence，正常 100Hz |
| 节点健康 | `0x280 + node` | 协议版本、状态、故障、session、VBUS，正常 20Hz |

协议版本为 1，广播操作码为 `ARM=1`、`SYNC=2`、`STOP=3`、`CLEAR_FAULT=4`、`DISCOVER=5`。状态机固定为 `UNCONFIGURED → READY → ARMED → RUNNING/HOLD`，任何致命条件进入 `FAULT`。所有多字节字段按 little-endian 编码；广播控制帧第 8 字节是 CRC8，其余帧依靠固定 ID/DLC、字段校验和 CAN 控制器自身 CRC。16位 sequence 按回绕规则比较，不能直接用普通整数大小判断新旧。

### MA600A 直连输出轴后，真正需要保存的是关节坐标

MA600A 直接连接导出轴，不存在减速器输入侧的多圈映射问题，但上电后仍要知道“当前 raw16 对应机构的哪个机械角度”。因此新增独立关节记录，保存节点号、捕获时 raw16、已知机械位置、方向、软限位、generation 和 CRC32。

记录使用两个 1KB 页交替写入：

```text
0x0801F400  joint record A
0x0801F800  joint record B
0x0801FC00  原有编码器校正表，不改动
```

写入时先完整生成并校验新记录，再擦除目标页、编程并回读；启动时从两个有效页中选择 generation 更新的一份。关节服务与 1kHz 运动服务之间使用短临界区发布运行时快照，避免 COM9 写配置时 ISR 看到一半新、一半旧的数据。

本轮已经在当前轴位置写入：

```text
node       = 1
known      = 0 mdeg
direction  = +1
limits     = [-90000, +90000] mdeg
generation = 0
CRC        = valid
```

重新烧录/复位后无需再次归零，最终一次恢复位置为 `-5mdeg`，与编码器量化和手动放置误差一致；原有 MA600A 校正记录继续有效。

### 非阻塞 CAN 驱动与 1kHz 安全时基

CAN1 使用 PA12/PA11、GPIO mux 9。180MHz 外设时钟下使用 `div=10`、`BTS1=14`、`BTS2=4`、`SJW=2` 得到 1Mbps。RX/TX 都使用有界软件队列；中断只搬运帧和更新诊断，不在 ISR 内等待邮箱或执行电机控制。

TMR6 独立产生 1kHz 运动服务节拍，参数为 prescaler=179、period=999。它负责 pending 点老化、SYNC lease、反馈/健康调度和状态迁移，不依赖 RT-Thread 线程是否及时运行。当前安全时间为：

| 条件 | 电机侧动作 |
| --- | --- |
| 预装点 30ms 内没有匹配 SYNC | 丢弃 pending 点，不启动 |
| RUNNING 后 50ms 没有新 SYNC | 进入 HOLD，冻结位置参考、速度前馈清零 |
| 500ms 没有有效 SYNC | 关闭位置控制并锁存 `FAULT_CAN_TIMEOUT` |
| STOP | 不依赖 session，立即停止并清除 pending |
| bus-off、运行中 RX 溢出或不可恢复 TX 故障 | 立即安全停机并锁存 `FAULT_CAN_BUS=0x200` |

ARM 只建立新 session，不会使能 PWM。只有第一组有效预装点和匹配 SYNC 才能进入位置控制，恢复通信也不能绕过重新 ARM。

### 这个坑：没有 CAN 对端时，错误中断把串口也饿死了

第一次把 Node 1 配好后，CAN 总线上没有能够 ACK 的对端。硬件很快累计发送错误并进入 bus-off，这本来应该只触发安全故障；实测却出现高优先级错误中断持续重入：

```text
STS   = 0xC0000502
INTEN = 0x000005CA
```

结果是优先级 3 的 CAN 错误 IRQ 长时间占用 MCU，COM9 shell 看起来像“卡死”。这不是串口坏了，也不是主循环死循环，而是把持续保持的硬件 error 状态当成一次性中断事件处理。

提交 `2a9a004` 将 error-passive、bus-off 等持续状态移到 10ms 安全轮询，只保留 RX、TX 和 RX-overflow 这类可消费事件的中断。随后还补了 bus-off 事件计数的竞态检查。最终无对端状态下：

```text
COM9 shell 仍可响应
fault      = 0x00000200 (FAULT_CAN_BUS)
node state = FAULT
EN         = 0
CCR1/2/3   = 2812/2812/2812
CCR4       = 5264
```

这个结果说明故障路径能安全落地，但不能把“无对端 bus-off”写成 CAN 通信通过。`FAULT_CAN_BUS` 是硬件通信致命故障，恢复接线和 ACK 条件后需要重启 MotorDriver，再 DISCOVER、ARM；协议 `CLEAR_FAULT` 不负责让已经 bus-off 的节点原地复活。

### 诊断与台架工具

新增 `can_status` 和 `can_diag_reset`。`can_status` 输出节点状态、session、pending/applied sequence、点龄、RX/TX、协议错误、RX overflow、bus-off、TX error 和 fault，并使用固定种子 `0x43414E31` 对整行数值做 XOR 校验，防止 COM9 截断行被脚本误收。

`can_diag_reset` 只有在所有电机模式停止、主状态 DISABLED、EN 关闭且 CAN 节点恰好处于 READY 时才执行；它只清诊断计数，不清故障、session、节点配置或队列。Stage 8 bench 的清理路径始终尝试三次广播 STOP，再发 COM9 `mc_stop`，最后独立检查 EN 和四个 PWM CCR，避免测试脚本异常时把电机留在运行态。

### 软件与构建验证

开发过程中每个模块都经过独立实现和复审。Task 9 在 `f808e3c` 上完成过 157 个 Python 用例、13 个 C 测试目标和 ARMCC5 clean build，并成功烧录、Verify；上电时确认未配置节点保持 DISABLED、EN=0、PWM 安全、编码器校正有效。

在最终提交 `2a9a004` 上重新验证：

```text
25 个可直接运行的 Python 测试脚本：全部通过
13 个 -std=c11 -Wall -Wextra -Werror C 测试目标：全部通过
CAN driver 静态契约：23 tests PASS
ARMCC5 clean build：Code=57084, RO=6512, RW=696, ZI=10728
构建结果：0 Error(s), 0 Warning(s)
当前镜像最高装载字节：0x0800F903
距离首个关节配置页 0x0801F400：64252 bytes
```

当前系统 Python 没有安装可选的 pytest，因此最终提交上的 Python 回归使用 25 个脚本直接入口执行；这不是测试失败。构建和测试只验证当前软件基线，本次写记录时没有重新抢占 COM9、烧录或驱动电机。

### 当前结论与联调边界

| 项目 | 当前结论 |
| --- | --- |
| 单电机电流/速度/位置级联 | 已有独立实机记录，保持 `|Iq|<=0.5A` 基线 |
| CAN 协议、状态机、1kHz 调度 | 软件测试和 ARMCC5 构建通过 |
| Node 1 关节配置 | 已持久化，复位恢复通过 |
| 无对端 CAN 故障安全 | 已实测，故障锁存且 PWM/EN 安全 |
| X-Track DISCOVER/ARM/轨迹/SYNC | 待对端完成后实机验证 |
| 100Hz 连续 10 分钟、50/500ms watchdog | 软件时序已覆盖，实机 CAN 指标待测 |
| Node 2、双节点 applied sequence、同步偏差 | 未验证 |
| 五连杆机构与 MPS 字样轨迹 | 未验证 |

因此目前准确的说法是：MotorDriver 已具备单节点 CAN 控制所需的软件和 Node 1 持久化基础，并验证了“没有对端时必须安全失败”；还不能宣布单电机 CAN 100Hz 运动通过。下一步等 X-Track transport 完成，先用自由轴完成 Node 1 的 DISCOVER、ARM、100Hz 位置+速度前馈、STOP 和 50/500ms 门禁，再配置并独立验证 Node 2，最后进入双电机五连杆联调。

关键提交：`653cb39`（关节记录模型）、`057917d`（双页原子持久化）、`385a51c`（上电恢复关节零点）、`c8db5c5`（AT32 CAN 驱动）、`f04a11d`（同步运动状态机）、`9a20584`（1kHz 集成）、`7bbbc58`（资格测试工具）、`f808e3c`（诊断安全审查修复）、`2a9a004`（错误中断饥饿修复）。

## 2026-07-24 第二套驱动板/电机自检、标定与编码器诊断竞态修复

日期：2026-07-24
记录编号：2026-07-24-NODE2-LOCAL-HW-01
阶段：第二套 MotorDriver 上 CAN 前的本地资格检查
硬件：第二套 AT32M412 + MP6540H + MA600A 驱动板和自由轴电机
接口：J-Link V9，COM9 115200，VBUS 约 12.13V
代码基线：检查开始时为 `4765cae`

### 第一眼串口正常，但固件不是当前 CAN 版本

先发 `mc_stop`，板端能正常响应，EN 也确实为 0。不过继续查询时发现：

```text
joint_cfg_show: command not found
can_status: command not found
CCR4: 2500
```

当前 CAN 节点源码和 Keil 工程明确包含这两个命令，ADC 低边采样触发也应为 5264。因此先不让电机转，重新从当前工作树 clean build。focused CAN/关节配置测试通过，ARMCC5 为 0 Error/0 Warning；镜像最高装载字节为 `0x0800F903`，不会覆盖 `0x0801F400/0x0801F800/0x0801FC00` 三个保留页。J-Link 随后完成 Erase、Programming 和 Verify。

正确固件启动后的只读门禁：

```text
VBUS      = 12.133V
state     = DISABLED
fault     = CAL_INVALID（新板未标定的预期告警）
EN        = 0
CCR1/2/3  = 2812/2812/2812
CCR4      = 5264
encoder   = sample/accept 全部一致，bus/spike/stale=0
joint_cfg = record_present=0, node=0, service_ready=0
CAN       = id=0, RX/TX/error 全 0
```

### 电流零偏与 MA600A 自动标定

第一次 `mc_cal` 结果：

```text
PASS offset_valid=1
A/B/C = 2061/2060/2061 LSB
静止 corrected current = -22/+12/+9mA
valid_mask=0x07
invalid_total=0, invalid_consecutive=0, pi_freeze=0
```

随后执行 `enc_cal_start auto`。电机按流程正反转，约 13 秒完成：

```text
state       = DONE
progress    = 100%
valid       = 1
samples     = 134423
covered bins= 256
min/bin     = 417
max residual= 60mdeg
quality_ok  = 1
spikes      = 0
nonmono     = 0
```

门槛为 1000mdeg，本次最大残差 60mdeg。重启后 `cal_valid=1`、`zero_raw=32400`、fault=0，确认 `0x0801FC00` 标定记录已经恢复；重启后重新运行 `mc_cal`，最终留板零偏为 `2062/2059/2062`。

### 本地三级环受限烟测

没有写永久关节记录，只用 `mc_pos_zero 0` 将当时位置临时定义为 0，然后各走一次 ±5°：

| 目标 | 实际位置 | 误差 | Iq_ref | fault |
| --- | ---: | ---: | ---: | --- |
| +5.000° | +4.817° | +0.183° | +27mA | 0 |
| -5.000° | -4.762° | -0.238° | -46mA | 0 |

两点采样均为 tick=5264、valid_mask=0x07，invalid/freeze 不增长。这里仅确认第二套板的电流、速度、位置级联和正反方向能工作，不替代后续 100Hz CAN 轨迹、长时间运行和机构负载测试。

### 这个坑：`enc_status` 自己制造了编码器毛刺

烟测后的第一次停机快照出现：

```text
raw16   = 65535
spike   = 1
spd_elec= 5423803mrad/s
```

继续读取后服务自动恢复到真实 raw≈32160，但 spike 累计到 33，最后被拒绝值为 raw=0。底层编码器 errors=0，运动和标定期间也没有 spike，说明不能先把锅甩给磁铁或 SPI 线。

代码回溯发现，TMR7 在停机时仍以 4kHz 采集 MA600A；旧 `enc_status` 又在 RT-Thread 中调用 `encoder_service_poll_once_thread()`，与 TMR7 并发访问同一个 SPI2，并在读取前清除上一样本基准。一旦线程读碰到 0/0xFFFF，错误值会成为新基准，后续真实样本要连续拒绝 32 次才能重同步。

采用 TDD 增加静态契约：`enc_status` 必须只读 TMR7 已发布的 snapshot，不得在线程中再次读 SPI。旧实现按预期 RED；删除这一次线程轮询后 focused 测试转绿，ARMCC5 clean build：

```text
Code=56808, RO=6512, RW=696, ZI=10728
0 Error(s), 0 Warning(s)
exclusive image end = 0x0800F7F0
```

重新刷写、清诊断后连续五次查询，共观察 27736 个 4kHz 样本：

```text
sample = accept = 27736
bus    = 0
spike  = 0
stale  = 0
last_rejected = 0
```

因此目前确认的是诊断并发读问题已被消除；这不是用放宽 spike 门槛掩盖硬件毛刺。

### 当前安全状态和未完成项

最终状态：

```text
state=DISABLED, fault=0
EN=0
CCR1/2/3=2812/2812/2812, CCR4=5264
offset_valid=1
cal_valid=1
current=-9/-28/+37mA, sum=0mA
invalid_total=0, invalid_consecutive=0, pi_freeze=0
```

这块板虽然物理上计划作为 Node 2，但固件记录仍是 `node=0`。我没有擅自执行 `joint_cfg_set 2 ...`：永久记录会同时捕获当前位置作为机构已知角，必须先把五连杆关节放到约定机械零位，并确认方向和软限位。完成这一步后再做重启恢复、Node 2 DISCOVER/ARM、100Hz 轨迹和双节点同步测试。
