leazer/MPS_MotorDriver/application/motor_control/encoder_service.c

#include "encoder_service.h"
#include "encoder_tracker.h"
#include "board_motor_pins.h"
#include "encoder_acq_timer_at32m412.h"
#include "motor_control_isr.h"
#include "motor_encoder_at32m412.h"
#include "motor_params.h"
#include <string.h>

#define ENC_MAX_DELTA_PER_FOC_TICK  1024
#define ENC_MAX_DELTA_PER_TICK      ((ENC_MAX_DELTA_PER_FOC_TICK * (int32_t)PWM_FREQUENCY_HZ) / (int32_t)ENCODER_ACQ_TIMER_HZ)
#define ENC_CONSEC_ERROR_THRESHOLD  32u
#define ENC_SPEED_WINDOW_SAMPLES    16u
#define TWO_PI_F                    6.28318530718f
#define RAW16_TO_MRAD_NUM           6283

static volatile encoder_snapshot_t s_snapshot;
static uint16_t s_zero_raw;
static bool s_cal_valid;
static bool s_has_prev;
static bool s_has_corrected_prev;
static uint32_t s_consec_error_count;
static int16_t s_cal_table[CAL_TABLE_POINTS];
static int32_t s_speed_pos_hist[ENC_SPEED_WINDOW_SAMPLES];
static uint32_t s_speed_accept_hist[ENC_SPEED_WINDOW_SAMPLES];
static uint8_t s_speed_hist_filled;

static int16_t encoder_raw_delta(uint16_t prev, uint16_t now)
{
    return (int16_t)(now - prev);
}

static uint16_t encoder_apply_calibration(uint16_t raw)
{
    uint16_t idx;
    uint16_t frac;
    int16_t off0;
    int16_t off1;
    int32_t off_mdeg;
    int32_t off_raw;
    uint32_t idx_frac_q24;

    if (!s_cal_valid) {
        return raw;
    }

    idx_frac_q24 = (uint32_t)raw * 256u;
    idx = (uint16_t)(idx_frac_q24 >> 16);
    frac = (uint16_t)(idx_frac_q24 & 0xFFFFu);
    off0 = s_cal_table[idx];
    off1 = s_cal_table[(uint16_t)((idx + 1u) & 0xFFu)];
    off_mdeg = (int32_t)off0 + (((int32_t)(off1 - off0) * (int32_t)frac) >> 16);
    off_raw = (off_mdeg * 65536) / 360000;
    return (uint16_t)((int32_t)raw - off_raw);
}

static int32_t encoder_mech_mdeg_from_raw(uint16_t raw)
{
    return (int32_t)((uint32_t)raw * 360000u / 65536u);
}

static int32_t encoder_control_position_mdeg(int32_t corrected_unwrapped)
{
    int64_t counts;

    counts = (int64_t)corrected_unwrapped - (int64_t)s_zero_raw;
    counts *= (int64_t)MOTOR_ENCODER_DIRECTION;
    return (int32_t)((counts * 360000LL) / 65536LL);
}

static int32_t encoder_elec_mrad_from_position(uint16_t position)
{
    uint16_t mech_diff;
    float theta;

    if (MOTOR_ENCODER_DIRECTION < 0) {
        mech_diff = (uint16_t)(s_zero_raw - position);
    } else {
        mech_diff = (uint16_t)(position - s_zero_raw);
    }
    theta = ((float)mech_diff * (float)MOTOR_POLE_PAIRS * TWO_PI_F) / 65536.0f;
    while (theta >= TWO_PI_F) {
        theta -= TWO_PI_F;
    }
    while (theta < 0.0f) {
        theta += TWO_PI_F;
    }
    return (int32_t)(theta * 1000.0f);
}

static void encoder_speed_history_reset(void)
{
    memset(s_speed_pos_hist, 0, sizeof(s_speed_pos_hist));
    memset(s_speed_accept_hist, 0, sizeof(s_speed_accept_hist));
    s_speed_hist_filled = 0u;
    s_snapshot.speed_mech_mrad_s = 0;
    s_snapshot.speed_elec_mrad_s = 0;
}

static void encoder_update_window_speed(int32_t corrected_unwrapped, uint32_t accept_count)
{
    uint32_t idx;
    int32_t old_pos;
    uint32_t old_accept;
    uint32_t sample_span;
    int32_t pos_delta;
    int32_t mech_speed;

    idx = accept_count % ENC_SPEED_WINDOW_SAMPLES;
    if (s_speed_hist_filled >= ENC_SPEED_WINDOW_SAMPLES) {
        old_pos = s_speed_pos_hist[idx];
        old_accept = s_speed_accept_hist[idx];
        sample_span = accept_count - old_accept;
        if (sample_span > 0u) {
            pos_delta = corrected_unwrapped - old_pos;
            mech_speed = (int32_t)(((int64_t)pos_delta *
                                    (int64_t)ENCODER_ACQ_TIMER_HZ *
                                    (int64_t)RAW16_TO_MRAD_NUM) /
                                   ((int64_t)65536 * (int64_t)sample_span));
            mech_speed *= (int32_t)MOTOR_ENCODER_DIRECTION;
            s_snapshot.speed_mech_mrad_s = mech_speed;
            s_snapshot.speed_elec_mrad_s = mech_speed * (int32_t)MOTOR_POLE_PAIRS;
        }
    } else {
        s_speed_hist_filled++;
        s_snapshot.speed_mech_mrad_s = 0;
        s_snapshot.speed_elec_mrad_s = 0;
    }

    s_speed_pos_hist[idx] = corrected_unwrapped;
    s_speed_accept_hist[idx] = accept_count;
}

static int encoder_accept_sample(uint16_t raw, int16_t speed, int16_t delta)
{
    uint16_t corrected;
    int16_t corrected_delta;
    uint32_t next_accept_count;

    corrected = encoder_apply_calibration(raw);
    if (s_has_prev) {
        s_snapshot.raw_unwrapped += delta;
    } else {
        s_snapshot.raw_unwrapped = (int32_t)raw;
        s_has_prev = true;
    }

    if (s_has_corrected_prev) {
        corrected_delta = encoder_raw_delta(s_snapshot.corrected_raw16, corrected);
        s_snapshot.corrected_unwrapped += corrected_delta;
    } else {
        corrected_delta = 0;
        s_snapshot.corrected_unwrapped = (int32_t)corrected;
        s_has_corrected_prev = true;
        encoder_speed_history_reset();
    }

    next_accept_count = s_snapshot.accept_count + 1u;
    encoder_update_window_speed(s_snapshot.corrected_unwrapped, next_accept_count);

    s_snapshot.raw_delta = delta;
    s_snapshot.raw16 = raw;
    s_snapshot.corrected_raw16 = corrected;
    s_snapshot.corrected_delta = corrected_delta;
    s_snapshot.control_position_mdeg =
        encoder_control_position_mdeg(s_snapshot.corrected_unwrapped);
    s_snapshot.speed_raw = speed;
    s_snapshot.mech_mdeg = encoder_mech_mdeg_from_raw(raw);
    s_snapshot.raw_elec_mrad = encoder_elec_mrad_from_position(raw);
    s_snapshot.elec_mrad = encoder_elec_mrad_from_position(corrected);
    s_snapshot.valid = 1u;
    s_snapshot.fresh = 1u;
    s_snapshot.spike_rejected = 0u;
    s_snapshot.accept_count++;
    s_consec_error_count = 0u;
    return 0;
}

void encoder_service_init(void)
{
    memset((void *)&s_snapshot, 0, sizeof(s_snapshot));
    memset(s_cal_table, 0, sizeof(s_cal_table));
    s_zero_raw = 0u;
    s_cal_valid = false;
    s_has_prev = false;
    s_has_corrected_prev = false;
    s_consec_error_count = 0u;
    encoder_speed_history_reset();
}

int encoder_service_update_from_isr(void)
{
    uint16_t raw = 0u;
    int16_t speed = 0;

    if (motor_encoder_read_raw_frame(&raw, &speed) != 0) {
        return encoder_service_update_sample(0u, 0, 0u);
    }

    return encoder_service_update_sample(raw, speed, 1u);
}

int encoder_service_update_sample(uint16_t raw, int16_t speed, uint8_t bus_ok)
{
    int16_t delta = 0;

    s_snapshot.sample_count++;
    if (bus_ok == 0u) {
        s_snapshot.bus_error_count++;
        s_consec_error_count++;
        return -1;
    }

    if (s_has_prev) {
        delta = encoder_raw_delta(s_snapshot.raw16, raw);
        if ((delta > ENC_MAX_DELTA_PER_TICK) || (delta < -ENC_MAX_DELTA_PER_TICK)) {
            s_snapshot.spike_count++;
            s_snapshot.spike_rejected = 1u;
            s_snapshot.last_rejected_raw16 = raw;
            s_snapshot.last_rejected_delta = delta;
            s_consec_error_count++;
            if (s_consec_error_count >= ENC_CONSEC_ERROR_THRESHOLD) {
                s_has_prev = false;
                return encoder_accept_sample(raw, speed, 0);
            }
            return -2;
        }
    }

    return encoder_accept_sample(raw, speed, delta);
}

int encoder_service_acquire_once(void)
{
    uint16_t raw = 0u;
    int ret;

    ret = motor_encoder_read_angle_raw(&raw);
    if (ret == 0) {
        ret = encoder_service_update_sample(raw, 0, 1u);
        if (ret == 0) {
            encoder_tracker_update_sample(raw, 1u);
            motor_control_isr_on_encoder_sample(raw);
        }
        return ret;
    }

    encoder_tracker_update_sample(0u, 0u);
    return encoder_service_update_sample(0u, 0, 0u);
}

int encoder_service_poll_once_thread(void)
{
    s_has_prev = false;
    return encoder_service_update_from_isr();
}

bool encoder_service_get_snapshot(encoder_snapshot_t *out)
{
    if (out == 0) {
        return false;
    }
    *out = s_snapshot;
    if (s_snapshot.fresh == 0u) {
        s_snapshot.stale_count++;
    }
    s_snapshot.fresh = 0u;
    return s_snapshot.valid != 0u;
}

float encoder_service_get_electrical_angle_rad(void)
{
    return ((float)s_snapshot.elec_mrad) / 1000.0f;
}

float encoder_service_get_speed_electrical_rad_s(void)
{
    return ((float)s_snapshot.speed_elec_mrad_s) / 1000.0f;
}

int32_t encoder_service_get_control_position_mdeg(void)
{
    return s_snapshot.control_position_mdeg;
}

uint16_t encoder_service_get_raw16(void)
{
    return s_snapshot.raw16;
}

void encoder_service_set_zero(uint16_t raw)
{
    s_zero_raw = raw;
}

uint16_t encoder_service_get_zero(void)
{
    return s_zero_raw;
}

void encoder_service_set_calibration_table(const int16_t *table, bool valid)
{
    if (table != 0) {
        memcpy(s_cal_table, table, sizeof(s_cal_table));
    } else {
        memset(s_cal_table, 0, sizeof(s_cal_table));
    }
    s_cal_valid = valid;
    s_has_corrected_prev = false;
    encoder_speed_history_reset();
}

void encoder_service_reset_diagnostics(void)
{
    uint16_t raw;
    uint16_t corrected;
    int32_t unwrapped;
    int32_t corrected_unwrapped;
    uint8_t valid;

    raw = s_snapshot.raw16;
    corrected = s_snapshot.corrected_raw16;
    unwrapped = s_snapshot.raw_unwrapped;
    corrected_unwrapped = s_snapshot.corrected_unwrapped;
    valid = s_snapshot.valid;
    memset((void *)&s_snapshot, 0, sizeof(s_snapshot));
    s_snapshot.raw16 = raw;
    s_snapshot.corrected_raw16 = corrected;
    s_snapshot.raw_unwrapped = unwrapped;
    s_snapshot.corrected_unwrapped = corrected_unwrapped;
    s_snapshot.control_position_mdeg =
        encoder_control_position_mdeg(corrected_unwrapped);
    s_snapshot.valid = valid;
    s_has_prev = false;
    s_has_corrected_prev = false;
    s_consec_error_count = 0u;
    encoder_speed_history_reset();
}
