leazer/MPS_MotorDriver/project/inc/at32m412_416_wk_config.h

/* add user code begin Header */
/**
  **************************************************************************
  * @file     at32f402_405_wk_config.h
  * @brief    header file of work bench config
  **************************************************************************
  * Copyright (c) 2025, Artery Technology, All rights reserved.
  *
  * The software Board Support Package (BSP) that is made available to
  * download from Artery official website is the copyrighted work of Artery.
  * Artery authorizes customers to use, copy, and distribute the BSP
  * software and its related documentation for the purpose of design and
  * development in conjunction with Artery microcontrollers. Use of the
  * software is governed by this copyright notice and the following disclaimer.
  *
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
  **************************************************************************
  */
/* add user code end Header */

/* define to prevent recursive inclusion -----------------------------------*/
#ifndef __AT32M412_416_WK_CONFIG_H
#define __AT32M412_416_WK_CONFIG_H

#ifdef __cplusplus
extern "C" {
#endif

/* includes -----------------------------------------------------------------------*/
#include "stdio.h"
#include "at32m412_416.h"

/* private includes -------------------------------------------------------------*/
/* add user code begin private includes */

/* add user code end private includes */

/* exported types -------------------------------------------------------------*/
/* add user code begin exported types */

/* add user code end exported types */

/* exported constants --------------------------------------------------------*/
/* add user code begin exported constants */

/* add user code end exported constants */

/* exported macro ------------------------------------------------------------*/
/* add user code begin exported macro */

/* add user code end exported macro */

/* add user code begin dma define */
/* user can only modify the dma define value */
//#define DMA1_CHANNEL1_BUFFER_SIZE   0
//#define DMA1_CHANNEL1_MEMORY_BASE_ADDR   0
//#define DMA1_CHANNEL1_PERIPHERAL_BASE_ADDR  0

//#define DMA1_CHANNEL2_BUFFER_SIZE   0
//#define DMA1_CHANNEL2_MEMORY_BASE_ADDR   0
//#define DMA1_CHANNEL2_PERIPHERAL_BASE_ADDR   0

//#define DMA1_CHANNEL3_BUFFER_SIZE   0
//#define DMA1_CHANNEL3_MEMORY_BASE_ADDR   0
//#define DMA1_CHANNEL3_PERIPHERAL_BASE_ADDR   0

//#define DMA1_CHANNEL4_BUFFER_SIZE   0
//#define DMA1_CHANNEL4_MEMORY_BASE_ADDR   0
//#define DMA1_CHANNEL4_PERIPHERAL_BASE_ADDR   0

//#define DMA1_CHANNEL5_BUFFER_SIZE   0
//#define DMA1_CHANNEL5_MEMORY_BASE_ADDR   0
//#define DMA1_CHANNEL5_PERIPHERAL_BASE_ADDR   0

//#define DMA1_CHANNEL6_BUFFER_SIZE   0
//#define DMA1_CHANNEL6_MEMORY_BASE_ADDR   0
//#define DMA1_CHANNEL6_PERIPHERAL_BASE_ADDR   0

//#define DMA1_CHANNEL7_BUFFER_SIZE   0
//#define DMA1_CHANNEL7_MEMORY_BASE_ADDR   0
//#define DMA1_CHANNEL7_PERIPHERAL_BASE_ADDR   0
/* add user code end dma define */

/* Private defines -------------------------------------------------------------*/
#define LED_PIN    GPIO_PINS_8
#define LED_GPIO_PORT    GPIOB
#define VBUS_PIN    GPIO_PINS_6
#define VBUS_GPIO_PORT    GPIOA
#define SOC_PIN    GPIO_PINS_7
#define SOC_GPIO_PORT    GPIOA
#define SOB_PIN    GPIO_PINS_0
#define SOB_GPIO_PORT    GPIOB
#define SOA_PIN    GPIO_PINS_1
#define SOA_GPIO_PORT    GPIOB
#define nFAULT_PIN    GPIO_PINS_2
#define nFAULT_GPIO_PORT    GPIOB
#define PWM_EN_PIN    GPIO_PINS_10
#define PWM_EN_GPIO_PORT    GPIOB
#define PWMA_PIN    GPIO_PINS_8
#define PWMA_GPIO_PORT    GPIOA
#define PWMB_PIN    GPIO_PINS_9
#define PWMB_GPIO_PORT    GPIOA
#define PWMC_PIN    GPIO_PINS_10
#define PWMC_GPIO_PORT    GPIOA
#define SPI2_CS_PIN    GPIO_PINS_15
#define SPI2_CS_GPIO_PORT    GPIOA

/* exported functions ------------------------------------------------------- */
  /* system clock config. */
  void wk_system_clock_config(void);

  /* config periph clock. */
  void wk_periph_clock_config(void);

  /* nvic config. */
  void wk_nvic_config(void);

  /* init gpio function. */
  void wk_gpio_config(void);

  /* init adc-common function. */
  void wk_adc_common_init(void);

  /* init adc2 function. */
  void wk_adc2_init(void);

  /* init can1 function. */
  void wk_can1_init(void);

  /* init spi2 function. */
  void wk_spi2_init(void);

  /* init tmr1 function. */
  void wk_tmr1_init(void);

  /* init usart1 function. */
  void wk_usart1_init(void);

  /* init wdt function. */
  void wk_wdt_init(void);

/* add user code begin exported functions */

/* add user code end exported functions */

#ifdef __cplusplus
}
#endif

#endif
