leazer/MPS_MotorDriver/platform/at32m412/can_motion_timer_at32m412.h

#ifndef CAN_MOTION_TIMER_AT32M412_H
#define CAN_MOTION_TIMER_AT32M412_H

#ifdef __cplusplus
extern "C" {
#endif

#define CAN_MOTION_TIMER_HZ 1000u

void can_motion_timer_at32m412_init(void);

#ifdef __cplusplus
}
#endif

#endif /* CAN_MOTION_TIMER_AT32M412_H */
