leazer/MPS_MotorDriver/platform/at32m412/encoder_acq_timer_at32m412.h

#ifndef ENCODER_ACQ_TIMER_AT32M412_H
#define ENCODER_ACQ_TIMER_AT32M412_H

#ifdef __cplusplus
extern "C" {
#endif

#define ENCODER_ACQ_TIMER_HZ 4000u

void encoder_acq_timer_at32m412_init(void);

#ifdef __cplusplus
}
#endif

#endif /* ENCODER_ACQ_TIMER_AT32M412_H */
