leazer/MPS_MotorDriver/application/motor_app.h

#ifndef MOTOR_APP_H
#define MOTOR_APP_H

#ifdef __cplusplus
extern "C" {
#endif

#include "motor_control.h"

/* 应用层初始化: 加载标定, 初始化各模块 */
void motor_app_init(void);

/* 应用层主循环 (在 main while(1) 内调用, 内部可 rt_thread_mdelay) */
void motor_app_run(void);

/* 获取全局电机控制实例 (供 msh 命令查询状态) */
const motor_control_t *motor_app_get_control(void);

/* 获取可写全局电机控制实例 (供 ISR / 开环控制接口修改状态, 非 ISR 上下文调用) */
motor_control_t *motor_app_get_control_rw(void);

#ifdef __cplusplus
}
#endif

#endif /* MOTOR_APP_H */
