leazer/MPS_MotorDriver/project/src/at32m412_416_int.c

/* add user code begin Header */
/**
  **************************************************************************
  * @file     at32m412_416_int.c
  * @brief    main interrupt service routines.
  **************************************************************************
  * Copyright (c) 2025, Artery Technology, All rights reserved.
  *
  * The software Board Support Package (BSP) that is made available to
  * download from Artery official website is the copyrighted work of Artery.
  * Artery authorizes customers to use, copy, and distribute the BSP
  * software and its related documentation for the purpose of design and
  * development in conjunction with Artery microcontrollers. Use of the
  * software is governed by this copyright notice and the following disclaimer.
  *
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
  **************************************************************************
  */
/* add user code end Header */

/* includes ------------------------------------------------------------------*/
#include "at32m412_416_int.h"
#include "rtthread_app.h"

/* private includes ----------------------------------------------------------*/
/* add user code begin private includes */
#include "can_at32m412.h"
/* add user code end private includes */

/* private typedef -----------------------------------------------------------*/
/* add user code begin private typedef */

/* add user code end private typedef */

/* private define ------------------------------------------------------------*/
/* add user code begin private define */

/* add user code end private define */

/* private macro -------------------------------------------------------------*/
/* add user code begin private macro */

/* add user code end private macro */

/* private variables ---------------------------------------------------------*/
/* add user code begin private variables */

/* add user code end private variables */

/* private function prototypes --------------------------------------------*/
/* add user code begin function prototypes */

/* add user code end function prototypes */

/* private user code ---------------------------------------------------------*/
/* add user code begin 0 */

/* add user code end 0 */

/* external variables ---------------------------------------------------------*/
/* add user code begin external variables */

/* add user code end external variables */

/**
  * @brief  this function handles nmi exception.
  * @param  none
  * @retval none
  */
void NMI_Handler(void)
{
  /* add user code begin NonMaskableInt_IRQ 0 */

  /* add user code end NonMaskableInt_IRQ 0 */

  /* add user code begin NonMaskableInt_IRQ 1 */

  /* add user code end NonMaskableInt_IRQ 1 */
}

/**
  * @brief  this function handles memory manage exception.
  * @param  none
  * @retval none
  */
void MemManage_Handler(void)
{
  /* add user code begin MemoryManagement_IRQ 0 */

  /* add user code end MemoryManagement_IRQ 0 */
  /* go to infinite loop when memory manage exception occurs */
  while (1)
  {
    /* add user code begin W1_MemoryManagement_IRQ 0 */

    /* add user code end W1_MemoryManagement_IRQ 0 */
  }
}

/**
  * @brief  this function handles bus fault exception.
  * @param  none
  * @retval none
  */
void BusFault_Handler(void)
{
  /* add user code begin BusFault_IRQ 0 */

  /* add user code end BusFault_IRQ 0 */
  /* go to infinite loop when bus fault exception occurs */
  while (1)
  {
    /* add user code begin W1_BusFault_IRQ 0 */

    /* add user code end W1_BusFault_IRQ 0 */
  }
}

/**
  * @brief  this function handles usage fault exception.
  * @param  none
  * @retval none
  */
void UsageFault_Handler(void)
{
  /* add user code begin UsageFault_IRQ 0 */

  /* add user code end UsageFault_IRQ 0 */
  /* go to infinite loop when usage fault exception occurs */
  while (1)
  {
    /* add user code begin W1_UsageFault_IRQ 0 */

    /* add user code end W1_UsageFault_IRQ 0 */
  }
}

/**
  * @brief  this function handles svcall exception.
  * @param  none
  * @retval none
  */
void SVC_Handler(void)
{
  /* add user code begin SVCall_IRQ 0 */

  /* add user code end SVCall_IRQ 0 */
  /* add user code begin SVCall_IRQ 1 */

  /* add user code end SVCall_IRQ 1 */
}

/**
  * @brief  this function handles debug monitor exception.
  * @param  none
  * @retval none
  */
void DebugMon_Handler(void)
{
  /* add user code begin DebugMonitor_IRQ 0 */

  /* add user code end DebugMonitor_IRQ 0 */
  /* add user code begin DebugMonitor_IRQ 1 */

  /* add user code end DebugMonitor_IRQ 1 */
}

/**
  * @brief  this function handles systick handler.
  * @param  none
  * @retval none
  */
void SysTick_Handler(void)
{
  /* add user code begin SysTick_IRQ 0 */

  /* add user code end SysTick_IRQ 0 */

  rt_interrupt_enter();

  rt_tick_increase();

  rt_interrupt_leave();

  /* add user code begin SysTick_IRQ 1 */

  /* add user code end SysTick_IRQ 1 */
}

/**
  * @brief  this function handles ADC1 2 handler.
  * @param  none
  * @retval none
  */
void ADC1_2_IRQHandler(void)
{
  /* add user code begin ADC1_2_IRQ 0 */

  /* add user code end ADC1_2_IRQ 0 */

  /* add user code begin ADC1_2_IRQ 1 */

  /* add user code end ADC1_2_IRQ 1 */
}

/**
  * @brief  this function handles CAN1 RX handler.
  * @param  none
  * @retval none
  */
void CAN1_RX_IRQHandler(void)
{
  /* add user code begin CAN1_RX_IRQ 0 */
  can_at32m412_irq_rx();
  /* add user code end CAN1_RX_IRQ 0 */

  /* add user code begin CAN1_RX_IRQ 1 */

  /* add user code end CAN1_RX_IRQ 1 */
}

/* add user code begin 1 */

void CAN1_TX_IRQHandler(void)
{
  can_at32m412_irq_tx();
}

void CAN1_STAT_IRQHandler(void)
{
  can_at32m412_irq_status();
}

void CAN1_ERR_IRQHandler(void)
{
  can_at32m412_irq_error();
}

/* add user code end 1 */
