leazer/MPS_MotorDriver/project/src/at32m412_416_wk_config.c

/* add user code begin Header */
/**
  **************************************************************************
  * @file     at32f402_405_wk_config.c
  * @brief    work bench config program
  **************************************************************************
  * Copyright (c) 2025, Artery Technology, All rights reserved.
  *
  * The software Board Support Package (BSP) that is made available to
  * download from Artery official website is the copyrighted work of Artery.
  * Artery authorizes customers to use, copy, and distribute the BSP
  * software and its related documentation for the purpose of design and
  * development in conjunction with Artery microcontrollers. Use of the
  * software is governed by this copyright notice and the following disclaimer.
  *
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
  **************************************************************************
  */
/* add user code end Header */

#include "at32m412_416_wk_config.h"

/* private includes ----------------------------------------------------------*/
/* add user code begin private includes */

/* add user code end private includes */

/* private typedef -----------------------------------------------------------*/
/* add user code begin private typedef */

/* add user code end private typedef */

/* private define ------------------------------------------------------------*/
/* add user code begin private define */

/* add user code end private define */

/* private macro -------------------------------------------------------------*/
/* add user code begin private macro */

/* add user code end private macro */

/* private variables ---------------------------------------------------------*/
/* add user code begin private variables */

/* add user code end private variables */

/* private function prototypes --------------------------------------------*/
/* add user code begin function prototypes */

/* add user code end function prototypes */

/* private user code ---------------------------------------------------------*/
/* add user code begin 0 */

/* add user code end 0 */

/**
  * @brief  system clock config program
  * @note   the system clock is configured as follow:
  *         system clock (sclk)   = (hext * pll_ns)/(pll_ms * pll_fr)
  *         system clock source   = HEXT_VALUE
  *         - lick                = on
  *         - lext                = off
  *         - hick                = on
  *         - hext                = off
  *         - hext                = HEXT_VALUE
  *         - sclk                = 180000000
  *         - ahbdiv              = 1
  *         - ahbclk              = 180000000
  *         - apb1div             = 1
  *         - apb1clk             = 180000000
  *         - apb2div             = 1
  *         - apb2clk             = 180000000
  *         - apb3div             = 4
  *         - apb3clk             = 45000000
  *         - pll_ns              = 90
  *         - pll_ms              = 1
  *         - pll_fr              = 4
  *         - flash_wtcyc         = 5 cycle
  * @param  none
  * @retval none
  */
void wk_system_clock_config(void)
{
  /* reset crm */
  crm_reset();

  /* config flash psr register */
  flash_psr_set(FLASH_WAIT_CYCLE_5);

  /* enable pwc periph clock */
  crm_periph_clock_enable(CRM_PWC_PERIPH_CLOCK, TRUE);
  
  /* config ldo voltage */
  pwc_ldo_output_voltage_set(PWC_LDO_OUTPUT_1V3);

  /* enable lick */
  crm_clock_source_enable(CRM_CLOCK_SOURCE_LICK, TRUE);

  /* wait till lick is ready */
  while(crm_flag_get(CRM_LICK_STABLE_FLAG) != SET)
  {
  }

  /* enable hext */
  crm_clock_source_enable(CRM_CLOCK_SOURCE_HEXT, TRUE);

  /* wait till hext is ready */
  while(crm_hext_stable_wait() == ERROR)
  {
  }

  /* enable hick */
  crm_clock_source_enable(CRM_CLOCK_SOURCE_HICK, TRUE);

  /* wait till hick is ready */
  while(crm_flag_get(CRM_HICK_STABLE_FLAG) != SET)
  {
  }

  /* config pll clock resource */
  crm_pll_config(CRM_PLL_SOURCE_HEXT, 90, 1, CRM_PLL_FR_4);
  /* enable pll */
  crm_clock_source_enable(CRM_CLOCK_SOURCE_PLL, TRUE);
  /* wait till pll is ready */
  while(crm_flag_get(CRM_PLL_STABLE_FLAG) != SET)
  {
  }

  /* config ahbclk */
  crm_ahb_div_set(CRM_AHB_DIV_1);

  /* config apb3clk, the maximum frequency of APB3 clock is 90 MHz */
  crm_apb3_div_set(CRM_APB3_DIV_4);

  /* config apb2clk, the maximum frequency of APB2 clock is 180 MHz */
  crm_apb2_div_set(CRM_APB2_DIV_1);

  /* config apb1clk, the maximum frequency of APB1 clock is 180 MHz */
  crm_apb1_div_set(CRM_APB1_DIV_1);

  /* enable auto step mode */
  crm_auto_step_mode_enable(TRUE);

  /* select pll as system clock source */
  crm_sysclk_switch(CRM_SCLK_PLL);

  /* wait till pll is used as system clock source */
  while(crm_sysclk_switch_status_get() != CRM_SCLK_PLL)
  {
  }

  /* disable auto step mode */
  crm_auto_step_mode_enable(FALSE);

  /* update system_core_clock global variable */
  system_core_clock_update();
}

/**
  * @brief  config periph clock
  * @param  none
  * @retval none
  */
void wk_periph_clock_config(void)
{
  /* Stage 0: 函数体已清空, 外设时钟初始化移至 platform 层 (spec 方案 Y) */
}

/**
  * @brief  nvic config
  * @param  none
  * @retval none
  */
void wk_nvic_config(void)
{
  /* Stage 0: 函数体已清空, NVIC 配置移至 platform 层 (spec 方案 Y) */
}

/**
  * @brief  init gpio_input/gpio_output/gpio_analog/eventout function.
  * @param  none
  * @retval none
  */
void wk_gpio_config(void)
{
  /* Stage 0: 函数体已清空, GPIO 配置移至 platform 层 (spec 方案 Y) */
}

/**
  * @brief  init usart1 function
  * @param  none
  * @retval none
  */
void wk_usart1_init(void)
{
  /* Stage 0: 函数体已清空, USART1 初始化移至 platform 层 (spec 方案 Y) */
}

/**
  * @brief  init can1 function.
  * @param  none
  * @retval none
  */
void wk_can1_init(void)
{
  /* Stage 0: 函数体已清空, CAN1 初始化移至 platform 层 (spec 方案 Y) */
}

/**
  * @brief  init adc-common function.
  * @param  none
  * @retval none
  */
void wk_adc_common_init(void)
{
  /* Stage 0: 函数体已清空, ADC 初始化移至 platform 层 (spec 方案 Y) */
}

/**
  * @brief  init adc2 function.
  * @param  none
  * @retval none
  */
void wk_adc2_init(void)
{
  /* Stage 0: 函数体已清空, ADC2 初始化移至 platform 层 (spec 方案 Y) */
}

/**
  * @brief  init tmr1 function.
  * @param  none
  * @retval none
  */
void wk_tmr1_init(void)
{
  /* Stage 0: 函数体已清空, TMR1 PWM 初始化移至 platform 层 (spec 方案 Y) */
}

/**
  * @brief  init spi2 function
  * @param  none
  * @retval none
  */
void wk_spi2_init(void)
{
  /* Stage 0: 函数体已清空, SPI2 初始化移至 platform 层 (spec 方案 Y) */
}

/**
  * @brief  init wdt function.
  * @param  none
  * @retval none
  */
void wk_wdt_init(void)
{
  /* Stage 0: 函数体已清空, WDT 初始化移至 platform 层 (spec 方案 Y) */
}

/* add user code begin 1 */

/* add user code end 1 */
