leazer/MPS_MotorDriver/project/inc/finsh_config.h

/* FinSH config file */

#ifndef __MSH_CFG_H__
#define __MSH_CFG_H__

// <<< Use Configuration Wizard in Context Menu >>>
#define RT_USING_FINSH
#define FINSH_USING_MSH
#define FINSH_USING_MSH_ONLY
// <h>FinSH Configuration
// <o>the priority of finsh thread <1-30>
//  <i>the priority of finsh thread
//  <i>Default: 21
#define FINSH_THREAD_PRIORITY       21
// <o>the stack of finsh thread <1-4096>
//  <i>the stack of finsh thread
//  <i>Default: 4096  (4096Byte)
#define FINSH_THREAD_STACK_SIZE     1024

#define FINSH_USING_SYMTAB
// <c1>Enable command description
//  <i>Enable command description
#define FINSH_USING_DESCRIPTION
//  </c>

// <c1>Enable history mode
//  <i>Enable history mode
#define FINSH_USING_HISTORY
//  </c>
// </h>

// <<< end of configuration section >>>
#endif
