leazer/MPS_MotorDriver/(commit log)

2026-06-01 Initial commit: MPS MotorDriver project based on AT32M412/M416
    - AT32 WorkBench project with CMake + GCC build system
    - CMSIS Cortex-M4 core & device support
    - AT32M412/M416 peripheral drivers
    - RT-Thread middleware integration
    - MDK (Keil) uVision project support
    - Startup code and linker script
2026-06-07 Add MA600A driver and SPI2 debug integration
2026-06-21 docs: add FOC design spec and Plan 1 (stage 0 project baseline)
    - specs/2026-06-22-mps-foc-design.md: 48KB design doc covering architecture,
    PWM/ADC timing, FOC ISR, SVPWM, current sensing, MA600A off-axis calibration,
    CAN protocol, fault management, 9-stage task breakdown
    - plans/2026-06-22-plan1-project-baseline.md: 12-task implementation plan for
    Stage 0 (directory restructure, skeleton files, CMake wiring, flash layout)
2026-06-21 docs: add FOC design spec and plan1; commit stage0 baseline assets
2026-06-21 feat(stage0): add board_motor_pins.h centralized pin definitions
2026-06-21 feat(stage0): add motor_params.h centralized parameter definitions
2026-06-21 feat(stage0): add application layer skeletons (foc_core/loops/isr/fault/calib/app)
2026-06-21 feat(stage0): add platform layer skeletons (current_sense/encoder/protect/flash/clock)
2026-06-21 feat(stage0): add communication layer skeletons (can_protocol/can_at32m412)
2026-06-21 refactor(stage0): empty wk_*_init bodies (keep wk_system_clock_config, spec scheme Y)
2026-06-21 refactor(stage0): slim main.c to motor_app entry; wire all new sources into CMakeLists.txt
2026-06-21 build(stage0): reserve last 1KB flash sector for calibration data (LENGTH 128K->127K)
2026-06-21 test(stage0): add syntax-check tests for foc_clarke/current_sense_calc/fault_manager
2026-06-21 docs(stage0): record Stage 0 completion in CLAUDE.md and FOC dev log
2026-06-21 build(keil): sync uvprojx with stage0 sources; add build/flash/clean bat scripts
2026-06-21 fix(stage1): adapt PWM timing constants to 180MHz sclk (ARR 2999->5624)
    [board_motor_pins.h]
2026-06-21 feat(stage1): add board_init_at32m412 (clock+gpio+nvic centralized init)
2026-06-21 feat(stage1): implement TMR1 center-aligned 16kHz 3-phase PWM (TWO_WAY_3, RCR=1)
2026-06-21 feat(stage1): wire board_init+motor_pwm into motor_app; add board_init to Keil project
2026-06-21 docs(stage1): update spec timing to 180MHz, note PRIMASK vs BASEPRI, record Stage 1 completion
2026-06-22 fix(finsh): correct USART1 PB6/PB7 IOMUX from MUX_0 to MUX_7
    [board_motor_pins.h]
2026-06-22 feat(finsh): add board_usart1_init to platform layer (PB6/PB7 MUX_7, 115200 8N1)
2026-06-22 refactor(finsh): board.c uart_init calls board_usart1_init (platform layer)
2026-06-22 feat(finsh): add motor_shell.c with 8 msh debug commands (pwm/led/mc/fault/encoder)
2026-06-22 fix(finsh): move board_clock/gpio/nvic init into rt_hw_board_init to fix serial
    [board.c, main.c, motor_app.c]
2026-06-22 fix(finsh): yield CPU in motor_app_run loop so finsh thread gets scheduled
    [motor_app.c]
2026-06-22 fix+docs: LED polarity (active low); record finsh debug sessions and stage0/1 history
    [board_init_at32m412.c, board_motor_pins.h, motor_shell.c]
2026-06-22 docs(spec): add debug log convention to Stage workflow
2026-06-22 feat(stage2-4b): FOC core transforms, open-loop control, ADC current sensing, MA600A encoder
    Stage 2 - PWM与开环控制:
    - foc_core.c: 256点sin LUT + 线性插值, Clarke/Park/IPark, SVPWM(min-max零序注入)
    - motor_control_isr.c: OPEN_LOOP模式(角度斜坡->IPark->SVPWM->CCR), ISR骨架
    - motor_shell.c: mc_open/mc_stop/mc_debug msh命令(定点输出, kprintf不支持%f)
    - 修复: FAULT_CAL_INVALID告警不应阻止开环, 加FAULT_FATAL_MASK+fault_manager_any_fatal()
    Stage 3 - ADC同步采样与电流反馈:
    - current_sense_at32m412.c: ADC2注入序列3通道(SOA/SOB/SOC), TMR1_CH4谷底触发
    - VBUS普通序列软件触发读取, 1kHz分频采样, 替代ISR硬编码12V
    - 零偏标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
    [com9_test.py, current_sense_at32m412.c, current_sense_at32m412.h, fault_manager.c, fault_manager.h, flash_calibration_at32m412.c, flash_calibration_at32m412.h, foc_core.c]
2026-06-22 fix(stage4b): bench-acceptance root causes (6 bugs) + SPI/cal fixes
    Stage 4+4b 台架验收暴露的 6 个根因修复:
    1. open_loop/align 状态未互斥清理
    - open_loop_stop/align_stop 都清全部 active 标志, 不能只清自己的
    2. SPI 读角度恒 0 — 真因 GPIO mux (用户台架确认)
    - transfer16 改单次 16-bit 收发 (顺带保留, 对齐 AT 官方 AS5047P)
    - 根因是 PB3/4/5 复用号, 非软件时序
    2b. motor_encoder 误把 16-bit 当 12-bit 左移
    - MA600A 角度寄存器本就是 16-bit, 去掉 <<4
    3. 脚本遗漏零偏标定
    - stage4_bench.py 补 mc_cal + B0_offset_calibrated 断言
    4. 标定按电角度圈数算 (应按机械圈)
    - 新增 CA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
    [board_motor_pins.h, motor_calibration.c, motor_control_isr.c, motor_encoder_at32m412.c, motor_params.h, stage4_bench.py]
2026-06-22 docs(spec): Stage 5 current loop design
    - 方案 A: CURRENT 分支独立流水线, 不动 OPEN_LOOP/ALIGN
    - theta 来源 enc/ramp 双支持 (复用 s_ol_use_enc 模式, 独立 s_cur_use_enc)
    - mc_current <iq_ma> [enc|ramp] [speed_rpm_elec] 命令
    - 标准 PI + clamping 抗 windup
    - IQ_MAX 4.5A < IQ_OVERCURRENT 5.0A (0.5A 余量)
    - tests/stage5_bench.py 自动验收 (稳态误差 + 分支命中, 上升时间示波器测)
    - enc 模式强制要有效标定表 (CAL_INVALID 拒绝)
2026-06-23 docs(plan): Stage 5 current loop implementation plan (8 tasks)
2026-06-23 feat(stage5): add current loop params, IQ_MAX 8.0->4.5A
    - IQ_MAX_A 8.0->4.5 (< IQ_OVERCURRENT 5.0, 0.5A 余量)
    - IQ_MAX_MA 4500 (shell 层用)
    - CURRENT_RAMP_DEFAULT_RPM 300 (ramp 模式默认)
    - 复用现有 PID_ID_KP/KI + PID_CURRENT_OUT_LIMIT (已存在, 值 0.5/100 一致)
    - build: FLASH 56552B (43.49%), RAM 9432B (57.57%), 0 err 0 warn
2026-06-23 feat(stage5): implement current_loop PI + clamping + set_targets/reset
    - pid_f32_exec: 标准 PI + clamping (积分限幅 + 输出限幅, 双重抗 windup)
    - current_loop_run: Id/Iq 双轴, 误差 = 目标 - 实测
    - set_targets / reset: shell/ISR 模式切换用
    - 复用 PID_ID_KP/KI + PID_IQ_KP/KI + PID_CURRENT_*_LIMIT (motor_params.h)
    - ISR_DT_S 本地定义 (1/16000), #ifndef 守护避免与 ISR 重复
    - build: 0 err 0 warn, obj 604B text + 64B bss (2x pid_f32_t + 2 ref)
    [current_loop.c, current_loop.h]
2026-06-23 test(stage5): current_loop PI math unit tests (6 tests, host gcc)
    - 比例+单步积分 / 积分限幅 / 输出限幅 / reset / 稳态消误差 / kd-gate
    - replica 与 current_loop.c pid_f32_exec 逐行一致 (含 kd!=0 gate)
    - 6/6 passed (WSL gcc -std=c11 -Wall)
    [test_current_loop.c]
2026-06-23 feat(stage5): declare current mode ISR api + debug fields
    - 5 current_* api 声明 (start/stop/active/set_encoder_angle/set_speed)
    - debug 结构体 +5 字段 (cur_hits/id_ma/iq_ma/id_ref_ma/iq_ref_ma)
    - build: 0 err 0 warn
2026-06-23 feat(stage5): CURRENT mode ISR branch + current_* api + debug
    - CURRENT 分支: Clarke->Park->电流环 PI->IPark->SVPWM, theta 来源 enc/ramp
    (独立 s_cur_use_enc, 不复用 s_ol_use_enc, 模式隔离)
    - 5 接口: current_start/stop/active/set_encoder_angle/set_speed
    start 互斥清 OPEN_LOOP/ALIGN (根因1教训), 切 mode+ENABLED+使能输出/IRQ
    stop 清积分+disable_ovf_irq/disable_output+DISABLED (同 align_stop)
    - current_loop 新增 get_id_ref_A/get_iq_ref_A (供 mc_debug 快照)
    - debug +5 字段 (cur_hits/id_ma/iq_ma/id_ref_ma/iq_ref_ma)
    - motor_app_init 调 current_loop_init (PID 参数初始化)
    - build: FLASH 57988B (44.59%, +1436), RAM 9520B (58.11%, +88)
    - 6/6 unit te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
2026-06-23 feat(stage5): mc_cur command + mc_stop/mc_debug current support
    - mc_cur <iq_ma> [enc|ramp] [rpm_elec]: 启动电流环 (新命令)
    注: 与 mc_current (电流采样显示) 命名区分, 避免冲突
    shell 层前置检查: 故障/CAL_INVALID(enc 模式) 拒绝
    IQ_MAX_MA 限幅, mA->A 转换
    - mc_stop: 加 current_stop + align_stop (原仅 open_loop_stop), 三模式互斥清理
    - mc_debug: 加 cur 行 (active/hits/id/iq/id_ref/iq_ref mA)
    - build: FLASH 59572B (45.81%, +1564), RAM 9520B, 0 err (MSH ';' warn 既有)
2026-06-23 test(stage5): bench acceptance script (ramp/step/enc validation)
    - Section A: 前置 (mc_cal 零偏 + mc_cur usage)
    - Section B: ramp 强制 CAL_INVALID (验 enc 拒绝 + ramp 稳态 iq 500mA ±5% + id~0 + cur_hits 递增)
    - Section C: 阶跃 0.5A->1A (稳态误差 < 5%, 上升时间示波器测)
    - Section D: enc 模式 (标定后, iq 容差 10% 含 3.66° 残差)
    - parse_cur_line: 专用正则解析 mc_debug cur 行 (active/hits/id/iq/id_ref/iq_ref)
    - 命令名 mc_cur (非 mc_current, 避免与电流采样显示冲突)
    - py_compile 语法 OK, regex 对实际格式验证通过
2026-06-23 docs(stage5): CLAUDE.md current loop stage record + bench steps
    - Stage 5 Complete 段: 完成内容/关键决策/资源占用/新命令/台架步骤/已知限制
    - msh 命令表: +mc_cur, mc_stop/mc_debug 描述更新 (含电流环)
    - 资源: FLASH 59580B (45.81%, +3028), RAM 9520B (58.11%, +88)
2026-06-23 fix(stage5): C90 compliance - move 'float out' decl to block top
    ARMCC V5.06 默认 C90, 禁止语句后声明变量.
    WSL GCC 默认 C11 未报此错, 漏检 (CLAUDE.md 已记此约束).
    pid_f32_exec: float out 原在 if 语句后声明 -> 提到块顶与 p_out 一起.
    验证: gcc -std=c90 -pedantic -Wdeclaration-after-statement 无违规.
    其余 Stage 5 函数 (current_start/stop, mc_cur, CURRENT 分支) 声明
    均在块顶, C90 合规.
    [current_loop.c]
2026-06-23 fix(finish): getchar does not need delay for input
    [board.c]
2026-06-24 feat: MSH串口(USART1) DMA化改造
    USART1 (PB6/PB7, 115200 8N1) 后端从逐字节轮询改为 DMA 驱动:
    - RX: DMA1_CH3 循环模式写入 s_rx_ring[128] 环形 buffer,
    getchar 用 write_idx = 128 - CNDTR 计算 DMA 写指针,
    容忍窗口 87us -> 11.1ms, 整行粘贴不再丢字符
    - TX: DMA1_CH2 单次模式 + s_tx_stage[256], 一段 DMA 等 FDT+TDC,
    替代逐字节 while(TDBE)+while(TDC), CPU 占用降 ~10x
    - 0 中断方案 (DMA 完成靠轮询), 不启用 RT_USING_DEVICE,
    不改 RT-Thread 源码, hook 签名不变
    - 通道分配与官方 AT32M412_LV_MC_Library_Porject_V2.1.5 一致
    新增文件:
    platform/at32m412/board_usart1_dma.h (接口声明)
    platform/at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
2026-06-24 docs: MSH串口DMA改造设计文档 + .gitignore例外
    doc/msh_usart_dma_design_2026-06-24.md: 背景/根因/设计/通道分配/
    接口/风险/验证计划/资源占用预估/对比/参考代码引用.
    已验证通过 (2026-06-24 台架).
    .gitignore: 添加 !doc/msh_usart_dma_design_2026-06-24.md 例外
2026-06-24 docs: record PA7(SOC) ADC debug — chip pin hardware damage
    S5-DBG-001 调试记录:
    - 现象: SOC(PA7/ADC2_IN7) 读数 ~0x000F, SOA/SOB 正常 ~2048
    - 排查: PA7 复用含 OP2_OUT, 查 OPAMP/TMR1_CH1C/CMP2 三个驱动源
    假设A(OPAMP占用)被证伪: OPOUTSEL=1 读回0x100 确认, 仍1.65V
    假设B(TMR1_CH1C)排除: occ_output_state=FALSE
    假设C(CMP2)排除: 未设MUX
    - 决定性验证: PA0推挽置0→0V(对照), PA7推挽置0→1.65V(VREF/2)
    - 结论: 芯片PA7引脚硬件损坏, OPOUTSEL与故障无关
    - 致伤原因不明, 换芯片验证
2026-06-25 docs: update PA7 debug — chip swap + GPIO demo recovered, root cause TBD on 2nd board
    换片后实测追加:
    - 换芯片第一次烧电机固件 PA7 仍异常
    - 跑 AT32M412 标准 GPIO 例程 IO 反转后, 再烧电机固件 ADC 恢复正常
    - 暂时结论: 换片恢复, 但 GPIO 例程中间步骤搅动, 不能 100% 排除配置残留
    - 待第二块板首次只烧电机固件复测, 以区分芯片损坏 vs 配置残留
2026-06-25 fix(current_sense): analog GPIO pins don't need open_drain/pull config
    GPIO_MODE_ANALOG ignores gpio_out_type and gpio_pull fields (hardware
    routes pin directly to ADC). AT official example doesn't set these for
    analog pins. Remove the spurious assignment left from PA7 debug.
    [current_sense_at32m412.c]
2026-06-25 fix(finsh): rt_hw_console_getchar return int, not char
    根因: rt_hw_console_getchar 声明返回 char, 把 board_usart1_rx_dma_getchar()
    返回的 int (-1 = 无数据) 截断成 char (0xFF), 再提升回 int 变 255.
    shell.c finsh_getchar 的 if (ch < 0) 检查失败 (255 > 0), 把 255 当有效
    字符塞进方向键 ESC 序列中间, 破坏 ESC(0x1b) -> [(0x5b) -> A/B/C/D(0x41-44)
    三字节状态机, 导致 [A [B [C [D 被当普通字符回显.
    修复: rt_hw_console_getchar 改返回 int, -1 正确传递, shell 跳过无数据帧.
    同步修改 shell.c 的 extern 声明 (char -> int).
    [board.c]
2026-06-25 docs: 记录 finsh 方向键 [A [B [C [D bug (getchar char->int)
    S5-DBG-002: rt_hw_console_getchar 返回 char 导致 -1 被截断为 0xFF,
    破坏方向键 ESC 序列状态机. DMA 改造引入的回归.
2026-06-30 fix(foc): complete sin lookup table
    [foc_core.c]
2026-06-30 docs(encoder): add service calibration redesign plan
2026-07-02 chore: checkpoint motor control encoder work
2026-07-07 feat(encoder): decouple acquisition from foc isr
2026-07-09 Tune encoder calibration workflow
2026-07-09 Finalize encoder speed estimation
2026-07-09 Stabilize current loop bench protection
    [motor_control_isr.c, motor_params.h, test_current_fault_debounce_static.py, test_vbus_fault_static.py, test_vbus_timeout_static.py]
2026-07-09 Fix current sampling trigger window
    [current_sense_at32m412.c, current_sense_at32m412.h, motor_control_isr.c, motor_control_isr.h, motor_params.h, motor_pwm_at32m412.c, motor_pwm_at32m412.h, motor_shell.c]
2026-07-14 docs: design current sampling reconstruction
2026-07-14 docs: plan current sampling reconstruction
2026-07-14 feat: add current sample reconstruction core
2026-07-14 feat: align current samples with active pwm
2026-07-14 fix: publish pwm requests at update boundary
    [motor_pwm_at32m412.c, motor_pwm_at32m412.h, motor_shell.c, test_current_sampling_static.py, test_pwm_mapping_static.py]
2026-07-14 fix: reject invalid current feedback frames
    [fault_manager.h, motor_app.c, motor_control_isr.c, motor_control_isr.h, motor_params.h, test_current_fault_debounce_static.py, test_current_sampling_static.py, test_speed_loop.c]
2026-07-14 fix: latch current protection faults
    [motor_control_isr.c, test_current_fault_debounce_static.py, test_current_sampling_static.py]
2026-07-14 test: add current sampling diagnostics and bench matrix
2026-07-14 fix: require valid encoder calibration in bench
    [stage5_bench.py, test_current_sampling_static.py]
2026-07-14 fix: harden current sampling final review
    [current_sense_at32m412.c, current_sense_at32m412.h, motor_control_isr.c, motor_control_isr.h, motor_pwm_at32m412.c, motor_shell.c, stage5_bench.py, test_current_fault_debounce_static.py]
2026-07-14 fix: harden command lifecycle guards
    [motor_control_isr.c, motor_shell.c, test_final_fix_static.py]
2026-07-14 build: include current reconstruction in Keil
2026-07-20 docs: design low-side current polarity fix
2026-07-20 fix: normalize low-side current polarity
    [current_reconstruction.c, current_reconstruction.h]
2026-07-20 test: verify low-side current polarity on hardware
2026-07-20 test: make current bench evidence authoritative
2026-07-20 test: record authoritative current bench rerun
2026-07-20 docs: mark stale current mirror diagnosis obsolete
2026-07-20 docs: close current polarity bench debug record
2026-07-20 docs: design v1 current-loop comparison branch
2026-07-20 docs: plan v1 current-loop comparison backport
2026-07-20 docs: design encoder direction normalization
2026-07-20 feat: add V1 V2 motor scope debug signals
2026-07-20 fix: clear stale scope phase voltage
    [motor_control_isr.c, test_lksscope_static.py]
2026-07-20 docs: plan encoder direction speed recovery
2026-07-20 fix: normalize encoder control direction
    [board_motor_pins.h, encoder_acq_timer_at32m412.h, encoder_service.c, motor_params.h, test_encoder_direction.c, test_encoder_service_static.py]
2026-07-20 safety: limit initial speed loop current
2026-07-20 test: tolerate UART noise in speed bench
    [stage6_bench.py, test_stage6_bench.py]
2026-07-20 test: stabilize hardware speed bench setup
    [stage6_bench.py, test_stage6_bench.py]
2026-07-20 fix: tune low inertia speed control
    [encoder_service.c, motor_params.h, speed_loop.c, test_encoder_service_static.py, test_speed_loop.c, test_speed_loop_static.py]
2026-07-21 fix: validate speed bench telemetry
    [motor_shell.c, stage6_bench.py, test_speed_loop_static.py, test_stage6_bench.py]
2026-07-21 docs: design single motor position feedforward
2026-07-21 docs: plan single motor position feedforward
2026-07-21 feat: expose continuous motor position
2026-07-21 feat: add position velocity feedforward loop
2026-07-21 feat: cascade position speed and current control
2026-07-21 fix: include encoder service in position ISR
    [motor_control_isr.c, test_position_isr_static.py]
2026-07-21 feat: qualify single motor position tracking
2026-07-21 docs: record single motor position qualification
2026-07-21 docs: plan motor CAN node implementation
2026-07-21 docs: plan X-Track motor CAN transport
2026-07-21 feat: add persistent joint configuration model
2026-07-21 test: cover joint config validation edge cases
2026-07-21 feat: persist joint configuration atomically
2026-07-21 fix: support ARMCC5 joint storage assertions
    [flash_joint_config_at32m412.c, test_joint_config_static.py]
2026-07-21 fix: link joint storage in Keil
    [test_joint_config_static.py]
2026-07-21 fix: support ARMCC5 joint config assertions
    [joint_config.c]
2026-07-21 test: strengthen joint storage static checks
    [test_joint_config_static.py]
2026-07-21 feat: restore persistent joint zero
2026-07-21 test: strengthen joint config service contracts
    [test_joint_config_static.py]
2026-07-21 fix: document and verify CAN concurrency contracts
    [can_at32m412.h, test_can_at32m412_static.py]
2026-07-21 fix: preserve latched CAN motion faults
    [can_motion_service.c, test_can_motion_service.c]
2026-07-21 fix: preserve joint direction and atomic fault bits
    [fault_manager.c, fault_manager.h, joint_config_service.c, motor_app.c, motor_calibration.c, motor_control_isr.c, motor_protect_at32m412.c, motor_shell.c]
2026-07-21 fix: serialize joint configuration runtime state
    [joint_config_service.c, joint_config_service.h, motor_app.c, motor_shell.c, position_loop.c, test_can_motion_integration_static.py, test_joint_config_static.py, test_position_loop_static.py]
2026-07-21 fix: close CAN diagnostics safety gaps
    [can_at32m412.c, can_at32m412.h, can_motion_service.c, motor_shell.c, stage8_can_bench.py, test_can_at32m412_static.py, test_can_motion_integration_static.py, test_stage8_can_bench.py]
2026-07-21 fix: prevent CAN error interrupt starvation
    [can_at32m412.c, motor_app.c, test_can_at32m412_static.py, test_can_motion_integration_static.py]
2026-07-21 docs: finalize X-Track motor CAN transport plan
2026-07-21 docs: record MotorDriver CAN node development
2026-07-21 docs: design CANalyst Stage 8 peer
2026-07-21 docs: plan CANalyst Stage 8 peer
2026-07-21 test: add CANalyst Motor CAN peer
2026-07-21 fix: enforce CAN peer transaction ordering
    [canalyst_motor_peer.py, test_canalyst_motor_peer.py]
2026-07-22 tune: stiffen position response
    [motor_params.h, test_position_tuning_profile.py]
2026-07-23 fix: keep encoder diagnostics on timer-owned SPI
    [motor_shell.c, test_encoder_service_static.py]
2026-07-26 docs: design lksscope live motor tuning
2026-07-26 docs: plan lksscope live motor tuning
2026-07-28 feat: add live three-loop motor tuning
2026-07-28 fix: refresh merged tuning validation
    [test_position_tuning_profile.py]
2026-07-28 docs: design project landing readme
2026-07-28 docs: track V2 project image
